StyNW7/Terrava/iot/ear-tag-specifications/tv-et0-classic/terrava-classic-3d-viewer.html

TerravaSMART EAR TAG · TV-ET0 CLASSIC

# Interactive 3D model

Drag to orbit, scroll to zoom. Same geometry as the STEP/STL files.

Explode 0%

Show

Front shell Electronics

Colourway

Signature Mint Stealth

Envelope

42 × 66 × 18 mm

Weight

≈ 44 g with electronics

Radio

LoRaWAN AS923-2 (SX1262)

Sensors

IR temp · PPG · 6-axis IMU · GNSS

Power

LiPo 302535 ~250 mAh + 154 mW solar

Terrava · parametric CAD in cad/terrava_classic.py
