StyNW7/Terrava/iot/ear-tag-specifications/tv-et1-shield/terrava-ear-tag-3d-viewer.html

TerravaSMART EAR TAG · TV-ET1

# Interactive 3D model

Drag to orbit, scroll to zoom. Same geometry as the STEP/STL files.

Explode 0%

Show

Front shell Electronics

Colourway

Signature Field Stealth

Envelope

46 × 68 × 14 mm

Weight

≈ 48 g with electronics

Radio

LoRaWAN AS923-2 (SX1262)

Sensors

IR temp · PPG · 6-axis IMU · GNSS

Battery

LiPo 602535, ~500 mAh

Terrava · parametric CAD in cad/terrava_ear_tag.py
