StyNW7/Terrava/README-ind.md

<div align="center">

Logo Terrava

# Terrava

### AI-Powered Smart Livestock Ecosystem

**Rawat Lebih Awal. Kelola Lebih Cerdas. Tumbuh Lebih Berkelanjutan.**

Terrava menghubungkan smart ear tag, IoT, cloud, dan kecerdasan buatan agar peternak dapat memantau kesehatan ternak, mendeteksi risiko lebih awal, dan mengambil keputusan berbasis data.

<p>
  🇬🇧 <a href="README.md">English</a> &nbsp;|&nbsp; 🇮🇩 <b>Bahasa Indonesia</b>
</p>

<p>
  
  
  
  
</p>

<p>
  
  
  
  
  
  
  
  
  
  
  
  
</p>

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

<p>
  
  
  
</p>

<p>
  <a href="#-memulai"><b>Memulai</b></a> ·
  <a href="#-fitur-utama"><b>Fitur</b></a> ·
  <a href="#-screenshot"><b>Screenshot</b></a> ·
  <a href="#-tech-stack"><b>Tech Stack</b></a> ·
  <a href="#-akun-demo"><b>Akun Demo</b></a>
</p>

<br />

<picture>
  <source media="(prefers-color-scheme: dark)" srcset="images/screenshots/dark/dashboard.png" />
  Dashboard peternak Terrava
</picture>

<sub>Gambar di atas mengikuti tema GitHub Anda. Versi terang dan gelap dari setiap halaman ada di bagian <a href="#-screenshot">Screenshot</a>.</sub>

</div>

---

## 📑 Daftar Isi

- [Tentang Terrava](#-tentang-terrava)
- [Masalah yang Kami Selesaikan](#-masalah-yang-kami-selesaikan)
- [Cara Kerja](#-cara-kerja)
- [Fitur Utama](#-fitur-utama)
- [Smart Ear Tag](#-smart-ear-tag)
- [Arsitektur Monorepo](#-arsitektur-monorepo)
- [Screenshot](#-screenshot)
- [Tech Stack](#-tech-stack)
- [Struktur Proyek](#-struktur-proyek)
- [Memulai](#-memulai)
- [Akun Demo](#-akun-demo)
- [Environment Variables](#-environment-variables)
- [Data Demo dan Penyimpanan](#-data-demo-dan-penyimpanan)
- [Script yang Tersedia](#-script-yang-tersedia)
- [Deployment](#-deployment)
- [Untuk Siapa Terrava](#-untuk-siapa-terrava)
- [Tujuan Pembangunan Berkelanjutan](#-tujuan-pembangunan-berkelanjutan)
- [Roadmap](#-roadmap)
<!-- - [Tim](#-tim) -->
- [Ucapan Terima Kasih](#-ucapan-terima-kasih)
- [Lisensi](#-lisensi)

---

## 🌱 Tentang Terrava

**Terrava** adalah ekosistem peternakan cerdas yang membantu peternak menjaga kesehatan setiap ekor ternak selama 24 jam sehari, tanpa harus memeriksanya satu per satu secara manual.

**Smart ear tag** yang ringan merekam suhu tubuh, detak jantung, aktivitas, dan lokasi setiap ternak. Data dikirim melalui konektivitas jarak jauh **LoRa** ke gateway, lalu ke **cloud**, tempat **AI** mempelajari pola normal setiap ternak dan menandai hal yang tidak biasa. Peternak melihat semuanya dalam satu **dashboard web**: kesehatan ternak, tanda vital secara langsung, alert beserta rekomendasi tindakan awal, peta peternakan, perangkat, tim, dan laporan yang bisa diunduh.

> [!NOTE]
> Repository ini adalah **monorepo dengan empat layer independen**: `frontend/` (website publik dan dashboard peternak lengkap, prototipe yang berfungsi dengan data demo realistis), `backend/` (API NestJS + Prisma + PostgreSQL), `ai/` (model machine learning Python dan asisten Terra) dan `iot/` (firmware ear tag dan gateway, protokol payload, bridge LoRaWAN, dan simulator armada). Setiap layer bisa diinstal, dijalankan, dan diuji sendiri; integrasi antar-layer adalah langkah berikutnya. Lihat [Arsitektur Monorepo](#-arsitektur-monorepo).

<table>
  <tr>
    <td align="center" width="25%">🩺<br /><b>Deteksi lebih awal</b><br /><sub>Kenali risiko kesehatan sebelum gejalanya terlihat</sub></td>
    <td align="center" width="25%">⏱️<br /><b>Hemat waktu</b><br /><sub>Ganti pemeriksaan manual satu per satu dengan pemantauan berkelanjutan</sub></td>
    <td align="center" width="25%">📊<br /><b>Keputusan berbasis data</b><br /><sub>Catatan kesehatan, tren, dan laporan yang konsisten</sub></td>
    <td align="center" width="25%">🌍<br /><b>Peternakan berkelanjutan</b><br /><sub>Ternak lebih sehat, kerugian lebih kecil, sumber daya lebih efisien</sub></td>
  </tr>
</table>

---

## 🎯 Masalah yang Kami Selesaikan

| Tantangan di peternakan | Jawaban Terrava |
| --- | --- |
| **Gejala penyakit terdeteksi terlambat.** Perubahan kondisi baru disadari ketika gejalanya sudah terlihat jelas. | Pemantauan tanda vital berkelanjutan dan deteksi anomali AI memunculkan risiko sejak tahap paling awal. |
| **Pemantauan manual menguras waktu dan tenaga.** Memeriksa ternak satu per satu memakan waktu berjam-jam. | Ear tag melapor secara otomatis; dashboard menunjukkan ternak mana yang perlu perhatian saat ini juga. |
| **Data kesehatan tercatat tidak konsisten.** Catatan tersebar dan jarang terdokumentasi dengan rapi. | Setiap ternak memiliki profil digital berisi riwayat kesehatan, catatan tindakan, dan status perangkat. |
| **Respons yang lambat memperbesar kerugian.** Penanganan yang tertunda menurunkan produktivitas dan pendapatan. | Smart alert datang lengkap dengan tingkat keparahan, penanggung jawab, dan rekomendasi tindakan awal. |

---

## ⚙️ Cara Kerja

Enam langkah otomatis mengubah sinyal dari setiap ternak menjadi keputusan yang bisa langsung dijalankan.

```mermaid
flowchart LR
    A["🏷️ Smart Ear Tag<br/>suhu · detak jantung<br/>aktivitas · GPS"] --> B["📡 LoRa Gateway<br/>jarak jauh, hemat daya"]
    B --> C["☁️ Cloud<br/>penyimpanan & sinkronisasi aman"]
    C --> D["🧠 Analisis AI<br/>baseline per ternak<br/>deteksi anomali"]
    D --> E["📊 Dashboard & Alert<br/>status ternak · peringatan dini"]
    E --> F["👩‍🌾 Tindakan Peternak<br/>respons cepat dengan<br/>rekomendasi yang jelas"]
```

| Langkah | Yang terjadi |
| :---: | --- |
| 1️⃣ **Smart Ear Tag** | Merekam suhu, detak jantung, aktivitas, dan lokasi setiap ternak. |
| 2️⃣ **LoRa Gateway** | Mengirim data jarak jauh dengan konsumsi daya yang sangat rendah. |
| 3️⃣ **Cloud** | Menyimpan dan menyinkronkan data secara aman. |
| 4️⃣ **Analisis AI** | Mempelajari pola normal setiap ternak dan menandai anomali sebelum gejala terlihat. |
| 5️⃣ **Dashboard & Alert** | Menyajikan status ternak, tren, dan peringatan dini dalam satu tampilan. |
| 6️⃣ **Tindakan Peternak** | Peternak merespons cepat dengan panduan rekomendasi yang jelas. |

---

## 🧱 Arsitektur Monorepo

```mermaid
flowchart LR
  subgraph IOT["iot/  (C++ · Python)"]
    TAG["Firmware smart ear tag\nESP32 + LoRa + sensor"]
    GW["Firmware gateway LoRa"]
    SIM["Simulator armada · bridge LoRaWAN"]
  end
  subgraph BE["backend/  (NestJS · Prisma · PostgreSQL)"]
    ING["Ingest IoT + rule engine"]
    API["REST API + Socket.IO"]
    JOBS["Job: deteksi offline, insight,\nlaporan terjadwal, cuaca"]
  end
  subgraph AI["ai/  (FastAPI · scikit-learn · Claude)"]
    ML["Model kesehatan · deteksi anomali\nforecasting · estrus · heat stress"]
    BOT["Asisten Terra"]
  end
  FE["frontend/  (React · Vite PWA)"]
  TAG -- LoRaWAN / P2P --> GW --> ING
  SIM -. HTTP .-> ING
  ING --> API
  API -. "berikutnya: integrasi" .- FE
  API -. "berikutnya: integrasi" .- ML
  FE -. "berikutnya: widget chat" .- BOT
```

| Layer | Stack | Isi | Cara menjalankan |
| --- | --- | --- | --- |
| [`frontend/`](frontend) | React 18, TypeScript, Vite, Tailwind, PWA | Website publik + prototipe dashboard peternak lengkap (data demo di browser) | `npm install && npm run dev` |
| [`backend/`](backend) | NestJS 12, Prisma 7, PostgreSQL (Neon / Supabase / embedded), Socket.IO | API multi-tenant untuk semua modul dashboard, RBAC, ingest IoT dengan rule engine (alert yang de-duplikasi, eskalasi, dan auto-resolve), AI insight, laporan PDF/CSV dengan jadwal email, notifikasi (in-app, email, WhatsApp), event realtime | `npm run db:local` · `npm run db:deploy && npm run db:seed` · `npm run dev` |
| [`ai/`](ai) | Python 3.12, FastAPI, scikit-learn, Claude API | Klasifikasi kondisi (demam, heat stress, pernapasan, pincang, estrus, metabolik), skor kesehatan dengan penjelasan, deteksi anomali, forecasting Holt-Winters, analitik estrus dan heat stress, insight kawanan, chatbot Terra (streaming, tool use, mode offline) | `pip install -r requirements-dev.txt` · `python -m terrava_ai serve` |
| [`iot/`](iot) | C++ (PlatformIO, ESP32, RadioLib), Python | Protokol payload LoRa biner, firmware ear tag (sensor, LoRaWAN OTAA, deep sleep, buffer flash, downlink), gateway satu kanal, bridge TTN/ChirpStack, simulator armada berbasis skenario | `python -m terrava_iot simulate --api http://localhost:4000/api/v1` |

**Kontrak bersama, siap diintegrasikan**

- Backend memakai tipe yang sama dengan frontend (`frontend/src/types/dashboard.ts`): nama field, nilai kebab-case, dan teks dua bahasa `{ id, en }` yang sama; seed-nya mereproduksi dataset prototipe dengan id yang sama (`farm-1`, `LVS-001`, `DEV-001`, `ALT-001`...).
- Layer IoT mengirim persis format yang diterima `/api/v1/ingest/*`; formatter TTN, codec C, dan codec Python berbagi satu set test vector.
- Layer AI mengembalikan insight dalam bentuk `AIInsight` milik dashboard dan hasil kesehatan dengan pita status yang sama seperti backend.

**Sudah diverifikasi di repository ini**: backend — build TypeScript, 45 unit test, dan smoke test end-to-end 25 skenario terhadap database yang sudah di-seed; AI — 35 test (model, time series, API, tool loop asisten); IoT — 31 test termasuk kecocokan byte-per-byte antara codec Python dan formatter JavaScript TTN, uji loop tertutup simulator terhadap backend (telemetri → alert → perintah downlink → acknowledgement), serta build PlatformIO firmware ear tag (LoRaWAN dan P2P) dan gateway.

---

## ✨ Fitur Utama

### 🌐 Website Publik

| Halaman | Isi |
| --- | --- |
| **Home** | Hero, mitra, masalah yang dihadapi peternak, alur enam langkah, fitur inti, pratinjau dashboard, sorotan ear tag, target pengguna, kapabilitas prototipe, cerita pilot, dan FAQ |
| **About** | Visi dan misi, nilai-nilai, rekognisi, <!-- tim, -->dan kontribusi SDG |
| **Solutions** | Delapan solusi, masing-masing dengan masalah, jawaban Terrava, kapabilitas, dan manfaatnya |
| **Smart Ear Tag** | Gambaran produk, sensor, anatomi perangkat, konektivitas, energi, kenyamanan dan keamanan, alur data, serta spesifikasi |
| **How It Works** | Perjalanan data, alur kerja teknis, perjalanan peternak, peran pengguna, dan akses platform |
| **Impact** | Pilar dampak (kesehatan hewan, produktivitas, ketahanan pangan, peternakan berkelanjutan), grafik, SDGs, dan visi jangka panjang |
| **Contact** | Pilihan kontak, formulir kontak, dan FAQ |
| **Auth** | Login (dengan akun demo sekali klik), registrasi multi-langkah, lupa/reset password, dan onboarding |

### 🖥️ Dashboard Peternak

| Modul | Sorotan |
| --- | --- |
| 🏠 **Dashboard Overview** | Sapaan personal, KPI ternak, tren kesehatan, distribusi kesehatan, frekuensi alert, aktivitas, uptime perangkat, serta panel alert, ternak yang perlu perhatian, masalah perangkat, rekomendasi AI, dan tugas. **Export Ringkasan** mengunduh ringkasan dalam bentuk PDF. |
| 🐄 **Ternak** | Tabel yang bisa dicari dan difilter, dengan aksi massal dan ekspor CSV. Halaman detail dengan tab Overview, Tanda Vital, Riwayat Kesehatan, Alert, Lokasi, Perangkat, dan Timeline Aktivitas. Tambah atau ubah ternak (cek ID unik, unggah foto, pasang ear tag, simpan draf), pindah kandang, serta arsipkan atau pulihkan. |
| 💓 **Live Monitoring** | Tanda vital yang diperbarui setiap beberapa detik, penanda ternak yang melewati ambang alert Anda, tampilan kartu atau tabel, jeda/lanjutkan, dan **Mode Control Room** layar penuh. |
| 🚨 **Pusat Alert** | Filter berdasarkan tingkat keparahan, kategori, dan status. Tandai diketahui, selesaikan, buka kembali, atau tugaskan alert satu per satu maupun sekaligus. Setiap alert punya catatan, timeline, alert terkait, dan tombol **Buat Tugas**. |
| 🧠 **AI Insights** | Insight per kategori dan prioritas, tren risiko, serta penyelesaian tindakan. Tandai sudah ditinjau, sembunyikan (bisa diurungkan), atau jadikan insight sebagai tugas. |
| 🗺️ **Peta Peternakan** | Pin ternak berwarna sesuai kondisi kesehatan, kandang, gateway, geofence, layer peta/satelit, filter status, "tampilkan semua", dan daftar ternak yang tersinkron untuk terbang ke setiap ternak. |
| 🏡 **Peternakan dan Kandang** | Tambah dan ubah peternakan, tambah kandang, dan lihat statistik okupansi, kesehatan, dan perangkat per peternakan. |
| 📡 **Perangkat** | Ear tag dan gateway lengkap dengan baterai, sinyal, dan firmware. Restart, jalankan diagnostik, mulai atau akhiri perawatan, pasangkan ke ternak, dan tinjau log kejadian. |
| 👥 **Tim dan Staf** | Undang anggota, ubah peran dan penugasan peternakan, nonaktifkan atau hapus anggota (dengan perlindungan untuk diri sendiri dan Owner terakhir). |
| 📈 **Laporan dan Analitik** | Sepuluh grafik yang mengikuti filter secara langsung. Pustaka enam laporan (kesehatan, alert, perangkat, operasional peternakan, lingkungan/THI, staf) yang bisa **dipratinjau**, diunduh sebagai **PDF** atau **CSV** sungguhan, dan **dijadwalkan**. Setiap unduhan tersimpan di riwayat laporan. |
| ⚙️ **Pengaturan** | Profil (dengan foto), Pengaturan Peternakan, Notifikasi, Ambang Alert, Tampilan (tema, mode ringkas, sidebar), Keamanan (ganti password), serta Data dan Privasi (ekspor JSON, reset data demo, hapus akun). |

### 🧩 Di Seluruh Aplikasi

- 🌗 **Mode terang dan gelap**: mengikuti sistem atau pilihan Anda, diterapkan sebelum halaman tampil sehingga tidak berkedip.
- 🌏 **Dua bahasa**: terjemahan lengkap bahasa Indonesia dan Inggris, bisa diganti dari halaman mana pun.
- 📱 **Responsif**: dirancang untuk ponsel, tablet, hingga layar besar ruang kontrol.
- 📲 **PWA yang bisa dipasang**: tetap berjalan offline, menyimpan cache aplikasi dan tile peta, serta memberi tahu saat ada versi baru.
- 🔎 **Pencarian global** dengan <kbd>Ctrl</kbd> + <kbd>K</kbd>, panel bantuan dengan <kbd>?</kbd>, pusat notifikasi, dan breadcrumb.
- 🧭 **Filter di header**: pilihan peternakan dan rentang tanggal mengubah data di dashboard overview.
- 🔐 **Rute terlindungi**: halaman dashboard memerlukan login; sesi bisa diingat.
- ♿ **Aksesibel**: markup semantik, status fokus keyboard, dan dukungan reduced motion.
- 🖨️ **Ramah cetak**: halaman dashboard dicetak tanpa elemen navigasi.

---

## 🏷️ Smart Ear Tag

Smart ear tag Terrava dirancang hemat daya. Perangkat ini mengumpulkan data fisiologis, aktivitas, dan lokasi tanpa mengganggu ternak.

<div align="center">
  Smart ear tag Terrava pada sapi
  Anatomi smart ear tag Terrava
</div>

<br />

| Komponen | Spesifikasi |
| --- | --- |
| 🧠 MCU | Mikrokontroler 32-bit hemat daya |
| 🌡️ Sensor suhu | Sensor suhu tubuh digital |
| ❤️ Sensor detak jantung | Sensor optik detak jantung dan kadar oksigen |
| 🏃 Sensor gerak | Akselerometer dan giroskop 6 sumbu |
| 📍 GPS | Modul GPS hemat daya |
| 📡 Konektivitas | Nirkabel jarak jauh LoRa |
| 💾 Memori | Penyimpanan flash eksternal (menampung data sebelum dikirim) |
| 🔋 Baterai | Baterai isi ulang hemat daya, 60–80 hari tanpa solar (target) |
| ☀️ Panel surya | Dukungan pengisian daya tenaga surya (opsional) |
| ⏲️ Interval data | Pengiriman berkala yang bisa diatur |

---

## 📸 Screenshot

Setiap halaman ditampilkan dalam kedua tema. Screenshot diambil pada resolusi 1440 × 900 dengan antarmuka berbahasa Inggris; seluruh antarmuka juga tersedia dalam bahasa Indonesia.

<table>
  <tr>
    <th width="50%">☀️ Mode Terang</th>
    <th width="50%">🌙 Mode Gelap</th>
  </tr>
  <tr><td colspan="2" align="center"><b>Landing Page</b></td></tr>
  <tr>
    <td>Landing page, mode terang</td>
    <td>Landing page, mode gelap</td>
  </tr>
  <tr><td colspan="2" align="center"><b>Login dengan Akun Demo</b></td></tr>
  <tr>
    <td>Halaman login, mode terang</td>
    <td>Halaman login, mode gelap</td>
  </tr>
  <tr><td colspan="2" align="center"><b>Dashboard Overview</b></td></tr>
  <tr>
    <td>Dashboard overview, mode terang</td>
    <td>Dashboard overview, mode gelap</td>
  </tr>
  <tr><td colspan="2" align="center"><b>Daftar Ternak</b></td></tr>
  <tr>
    <td>Daftar ternak, mode terang</td>
    <td>Daftar ternak, mode gelap</td>
  </tr>
  <tr><td colspan="2" align="center"><b>Detail Ternak</b></td></tr>
  <tr>
    <td>Detail ternak, mode terang</td>
    <td>Detail ternak, mode gelap</td>
  </tr>
  <tr><td colspan="2" align="center"><b>Live Monitoring</b></td></tr>
  <tr>
    <td>Live monitoring, mode terang</td>
    <td>Live monitoring, mode gelap</td>
  </tr>
  <tr><td colspan="2" align="center"><b>Pusat Alert</b></td></tr>
  <tr>
    <td>Pusat alert, mode terang</td>
    <td>Pusat alert, mode gelap</td>
  </tr>
  <tr><td colspan="2" align="center"><b>AI Insights</b></td></tr>
  <tr>
    <td>AI insights, mode terang</td>
    <td>AI insights, mode gelap</td>
  </tr>
  <tr><td colspan="2" align="center"><b>Peta dan Pelacakan Peternakan</b></td></tr>
  <tr>
    <td>Peta peternakan, mode terang</td>
    <td>Peta peternakan, mode gelap</td>
  </tr>
  <tr><td colspan="2" align="center"><b>Laporan dan Analitik</b></td></tr>
  <tr>
    <td>Laporan dan analitik, mode terang</td>
    <td>Laporan dan analitik, mode gelap</td>
  </tr>
  <tr><td colspan="2" align="center"><b>Pustaka Laporan (PDF, CSV, dan Penjadwalan)</b></td></tr>
  <tr>
    <td>Pustaka laporan, mode terang</td>
    <td>Pustaka laporan, mode gelap</td>
  </tr>
  <tr><td colspan="2" align="center"><b>Pratinjau Laporan</b></td></tr>
  <tr>
    <td>Pratinjau laporan, mode terang</td>
    <td>Pratinjau laporan, mode gelap</td>
  </tr>
  <tr><td colspan="2" align="center"><b>Manajemen Perangkat</b></td></tr>
  <tr>
    <td>Manajemen perangkat, mode terang</td>
    <td>Manajemen perangkat, mode gelap</td>
  </tr>
  <tr><td colspan="2" align="center"><b>Halaman Smart Ear Tag</b></td></tr>
  <tr>
    <td>Halaman smart ear tag, mode terang</td>
    <td>Halaman smart ear tag, mode gelap</td>
  </tr>
</table>

<details>
<summary><b>📱 Tampilan mobile</b> (klik untuk membuka)</summary>
<br />

<table>
  <tr>
    <th>☀️ Landing</th>
    <th>☀️ Dashboard</th>
    <th>🌙 Landing</th>
    <th>🌙 Dashboard</th>
  </tr>
  <tr>
    <td>Landing mobile, mode terang</td>
    <td>Dashboard mobile, mode terang</td>
    <td>Landing mobile, mode gelap</td>
    <td>Dashboard mobile, mode gelap</td>
  </tr>
</table>

</details>

---

## 🛠️ Tech Stack

| Lapisan | Teknologi |
| --- | --- |
| **Framework** | [React 18](https://react.dev/) + [TypeScript 5.8](https://www.typescriptlang.org/) |
| **Build tool** | [Vite 6](https://vite.dev/) |
| **Styling** | [Tailwind CSS 3.4](https://tailwindcss.com/), `tailwindcss-animate`, `class-variance-authority`, `tailwind-merge` |
| **Animasi** | [Framer Motion 12](https://motion.dev/) (menghormati pengaturan reduced motion) |
| **Routing** | [React Router 7](https://reactrouter.com/) dengan rute dashboard yang terlindungi |
| **Form dan validasi** | [React Hook Form 7](https://react-hook-form.com/) + [Zod 4](https://zod.dev/) |
| **Tabel** | [TanStack Table 8](https://tanstack.com/table) |
| **Grafik** | [Recharts 3](https://recharts.org/) |
| **Peta** | [Leaflet 1.9](https://leafletjs.com/) + [React Leaflet 4](https://react-leaflet.js.org/) dengan tile CARTO, OpenStreetMap, dan Esri World Imagery |
| **Laporan** | [jsPDF 4](https://github.com/parallax/jsPDF) + [jspdf-autotable 5](https://github.com/simonbengtsson/jsPDF-AutoTable) (dimuat saat dibutuhkan), ekspor CSV |
| **Ikon dan UI** | [Lucide](https://lucide.dev/), komponen dasar Radix UI, pola shadcn/ui |
| **Notifikasi** | [react-hot-toast](https://react-hot-toast.com/) |
| **Tanggal** | [date-fns 4](https://date-fns.org/) |
| **PWA** | [vite-plugin-pwa](https://vite-pwa-org.netlify.app/) + Workbox |
| **Kualitas kode** | ESLint 9, `typescript-eslint`, aturan lint React Hooks |
| **Hosting** | [Vercel](https://vercel.com/) (SPA rewrites di `vercel.json`) |

**Layer backend, AI, dan IoT**

| Lapisan | Teknologi |
| --- | --- |
| **Framework API** | [NestJS 12](https://nestjs.com/) (Express 5), class-validator, Swagger / OpenAPI di `/docs` |
| **Database** | [PostgreSQL](https://www.postgresql.org/) melalui [Prisma 7](https://www.prisma.io/) (driver adapter pg) di [Neon](https://neon.tech/), [Supabase](https://supabase.com/), atau Postgres lokal embedded |
| **Auth & keamanan** | JWT access token + refresh token berotasi dengan deteksi reuse, bcrypt, guard RBAC, Helmet, rate limiting, audit log |
| **Realtime & job** | Gateway Socket.IO, cron job `@nestjs/schedule`, domain event EventEmitter |
| **Laporan & pesan** | PDFKit, CSV, Nodemailer (SMTP), gateway HTTP WhatsApp, cuaca Open-Meteo |
| **Layanan AI** | [FastAPI](https://fastapi.tiangolo.com/), [scikit-learn](https://scikit-learn.org/) (HistGradientBoosting, IsolationForest), NumPy, pandas |
| **Asisten** | [Claude](https://www.anthropic.com/claude) (`claude-opus-5-5`) melalui Anthropic Python SDK: streaming, tool use, prompt caching, server-side fallback; retrieval pengetahuan TF-IDF |
| **Firmware** | C++ / Arduino di ESP32 dengan [PlatformIO](https://platformio.org/), [RadioLib](https://github.com/jgromes/RadioLib) (LoRaWAN 1.1 OTAA, AS923-2), TinyGPS++, MAX3010x, MLX90614, MPU6050, XPowersLib, LittleFS |
| **Tooling IoT** | Python: codec biner, simulator armada, bridge MQTT (paho-mqtt) untuk The Things Stack / ChirpStack dengan outbox SQLite |
| **Pengujian** | Jest, pytest, smoke test end-to-end, test vector protokol bersama, Unity (firmware) |

---

## 🗂️ Struktur Proyek

```text
Terrava/
├── frontend/                    # Platform web Terrava (React + Vite)
│   ├── public/
│   │   ├── icons/               # Ikon PWA dan favicon
│   │   └── Images/              # Foto produk, mockup, avatar
│   ├── src/
│   │   ├── components/
│   │   │   ├── auth/            # Login, registrasi, kartu akun demo
│   │   │   ├── charts/          # Komponen grafik Recharts
│   │   │   ├── dashboard/       # Layout, header, sidebar, tabel, modal, panel
│   │   │   ├── devices/ farms/ livestock/ reports/ settings/ team/
│   │   │   ├── layout/          # Navbar dan footer publik
│   │   │   ├── sections/        # Section landing dan halaman marketing
│   │   │   ├── pwa/             # Prompt pemasangan dan pembaruan
│   │   │   └── ui/              # Komponen UI dasar
│   │   ├── context/             # Auth, Theme, Language, Settings, Data Store, Dashboard
│   │   ├── data/                # Dataset demo dan konten website
│   │   ├── hooks/               # Hook reusable (data store, laporan, perangkat, pengaturan…)
│   │   ├── i18n/                # Kamus bahasa Indonesia dan Inggris
│   │   ├── lib/                 # Laporan, ekspor PDF/CSV, tile peta, penjadwalan
│   │   ├── pages/               # Halaman publik, auth, dan dashboard
│   │   ├── schemas/             # Skema validasi Zod
│   │   ├── types/               # Tipe TypeScript bersama
│   │   └── utils/               # Waktu, gambar, ikon peta, pembacaan live
│   ├── .env.example             # Template API key peta
│   ├── vercel.json              # SPA rewrites untuk Vercel
│   ├── vite.config.ts           # Konfigurasi Vite, path alias, dan PWA
│   └── README.md                # Catatan teknis frontend
├── backend/                     # API NestJS + Prisma (lihat backend/README.md)
│   ├── prisma/                  # skema (28 model), migrasi, seed demo
│   ├── scripts/                 # Postgres embedded, smoke test end-to-end
│   └── src/                     # config, domain logic, common, modules/*
├── ai/                          # Layanan ML FastAPI + asisten Terra (lihat ai/README.md)
│   ├── terrava_ai/              # ml/ (model), chat/ (asisten + pengetahuan), api/
│   └── tests/
├── iot/                         # Firmware, protokol, bridge, simulator (lihat iot/README.md)
│   ├── protocol/                # PAYLOAD.md, codec C, formatter TTN, test vector
│   ├── firmware/ear-tag/        # Ear tag ESP32 (PlatformIO)
│   ├── firmware/gateway/        # Gateway LoRa ESP32 (PlatformIO)
│   └── terrava_iot/             # Codec Python, simulator, bridge MQTT
├── images/                      # Logo dan screenshot README (light/ dan dark/)
├── README.md                    # Dokumentasi (bahasa Inggris)
└── README-ind.md                # Dokumentasi (bahasa Indonesia)
```

---

## 🚀 Memulai

### Prasyarat

- [Node.js](https://nodejs.org/) **18 atau lebih baru** (disarankan 20 LTS)
- npm (sudah termasuk dalam Node.js)
- Git

### Instalasi

```bash
# 1. Clone repository
git clone https://github.com/StyNW7/Terrava.git

# 2. Masuk ke folder frontend
cd Terrava/frontend

# 3. Install dependency
npm install

# 4. (Opsional) tambahkan API key peta, lihat "Environment Variables"
cp .env.example .env.local

# 5. Jalankan development server
npm run dev
```

Buka **http://localhost:5173**, klik **Coba Dashboard Demo** atau **Login**, lalu masuk dengan akun demo.

> [!TIP]
> Aplikasi langsung berjalan tanpa konfigurasi apa pun. Tanpa API key peta, Peta Peternakan otomatis memakai tile OpenStreetMap.

### Mencoba PWA secara lokal

Service worker hanya dibuat pada build production:

```bash
npm run build
npm run preview
```

Chrome dan Edge di desktop atau Android menawarkan tombol **Install**. Di iOS, gunakan Safari → Share → **Add to Home Screen**.

### Menjalankan layer backend, AI, dan IoT

Setiap layer berdiri sendiri; jalankan yang Anda perlukan saja. Panduan lengkap ada di README masing-masing folder.

```bash
# Backend API (Node.js 22.12+) — http://localhost:4000/api/v1, dokumentasi di /docs
cd backend && npm install && cp .env.example .env
npm run db:local            # terminal 1: PostgreSQL embedded (atau pakai Neon / Supabase)
npm run db:deploy && npm run db:seed && npm run dev   # terminal 2

# Layanan AI (Python 3.11+) — http://localhost:8000/docs
cd ai && python -m venv .venv && .venv/Scripts/activate   # macOS/Linux: source .venv/bin/activate
pip install -r requirements-dev.txt && pip install -e . --no-deps
python -m terrava_ai serve

# Simulator IoT: ear tag virtual mengirim data ke backend
cd iot && python -m venv .venv && .venv/Scripts/activate
pip install -r requirements-dev.txt && pip install -e . --no-deps
python -m terrava_iot simulate --api http://localhost:4000/api/v1 --backfill 6 --speed 600 --scenario DEV-001=fever
```

---

## 🔑 Akun Demo

Prototipe ini dilengkapi akun dummy. Setiap akun langsung masuk ke dashboard peternak, atau gunakan tombol **Masuk langsung** di halaman login.

| Persona | Email | Password |
| --- | --- | --- |
| 👨‍🌾 Pemilik Peternakan | `demo@terrava.id` | `Terrava123` |
| 🧑‍💼 Manajer Peternakan | `manager@terrava.id` | `Terrava123` |
| 🩺 Dokter Hewan | `vet@terrava.id` | `Terrava123` |

> [!IMPORTANT]
> Kredensial ini hanya untuk demonstrasi. Autentikasi berjalan di browser; belum ada database pengguna sungguhan.

---

## 🔐 Environment Variables

Buat `frontend/.env.local` (diabaikan oleh git) dari `frontend/.env.example`.

| Variabel | Wajib | Fungsi |
| --- | :---: | --- |
| `VITE_CARTO_API_KEY` | Opsional | Basemap CARTO untuk Peta Peternakan mode terang dan gelap tanpa watermark "API KEY REQUIRED". Dapatkan key gratis di [carto.com/basemaps/apikey](https://carto.com/basemaps/apikey). |
| `VITE_ARCGIS_API_KEY` | Opsional | Hanya diperlukan jika layer satelit dipindahkan ke paket ArcGIS Location Platform. |

**Menjaga keamanan API key peta**

1. Di dashboard CARTO, batasi key hanya untuk domain Anda (misalnya `localhost` dan domain Vercel Anda). Key peta selalu terlihat di request browser, jadi pembatasan domain inilah yang melindunginya.
2. Simpan key di `.env.local`, yang tidak pernah di-commit.
3. Di Vercel, tambahkan variabel di **Project → Settings → Environment Variables** lalu lakukan redeploy.

Kredit peta untuk OpenStreetMap, CARTO, dan Esri tetap ditampilkan sebagai label atribusi kecil, sesuai ketentuan lisensinya.

---

## 💾 Data Demo dan Penyimpanan

Terrava berjalan dengan dataset yang realistis sehingga setiap fitur bisa langsung dicoba:

| Dataset | Jumlah |
| --- | --- |
| 🏡 Peternakan | 4 peternakan (Green Valley Farm, Lembang Dairy Farm, Nusantara Livestock Center, Terrava Demo Farm), masing-masing dengan kandang |
| 🐄 Ternak | 40 ekor dengan tanda vital, riwayat kesehatan, vaksinasi, dan lokasi |
| 📡 Perangkat | 20 perangkat (smart ear tag dan gateway) dengan log kejadian dan perawatan |
| 🚨 Alert | 18 alert dari kategori kesehatan, perilaku, lokasi, perangkat, lingkungan, dan cuaca |
| 🧠 AI insights | Insight dengan prioritas, tingkat keyakinan, dan rekomendasi tindakan |
| 👥 Tim | 10 anggota dengan peran dan penugasan peternakan |

Setiap aksi (menyelesaikan alert, menambah ternak, mengundang anggota, membuat tugas, dan lainnya) memperbarui satu data store bersama, sehingga perubahannya terlihat di semua halaman. Data disimpan di `localStorage` browser:

| Key | Isi |
| --- | --- |
| `terrava-demo-data` | Ternak, alert, perangkat, peternakan, tim, tugas, insight, riwayat laporan, dan jadwal |
| `terrava-settings` | Pengaturan pengguna (ambang alert, satuan, notifikasi, tampilan, dan lainnya) |
| `terrava-auth-session` | Sesi login |
| `terrava-theme` / `terrava-language` | Preferensi tema dan bahasa |
| `terrava-password-overrides` | Password yang diganti di Pengaturan, disimpan sebagai hash SHA-256 |

Untuk memulai dari awal, buka **Pengaturan → Data dan Privasi → Reset Data Demo**.

> [!NOTE]
> Karena belum ada backend, laporan terjadwal, notifikasi email/WhatsApp, undangan tim, dan formulir kontak masih disimulasikan di browser. Belum ada pesan yang benar-benar terkirim.

---

## 📜 Script yang Tersedia

Jalankan perintah berikut di dalam folder `frontend/`.

| Perintah | Keterangan |
| --- | --- |
| `npm run dev` | Menjalankan development server Vite dengan hot reload |
| `npm run build` | Pengecekan tipe TypeScript dan build production ke folder `dist/` |
| `npm run preview` | Menyajikan hasil build production secara lokal (termasuk service worker) |
| `npm run lint` | Menjalankan ESLint di seluruh proyek |

---

## ☁️ Deployment

Terrava adalah single-page app statis dan mudah di-deploy ke **Vercel**:

1. Import repository di Vercel.
2. Atur **Root Directory** ke `frontend`.
3. Framework preset: **Vite**. Build command `npm run build`, output directory `dist`.
4. Tambahkan `VITE_CARTO_API_KEY` (opsional) di Environment Variables.
5. Deploy. `frontend/vercel.json` sudah mengarahkan semua rute ke `index.html`, sehingga tautan langsung seperti `/dashboard/alerts` tetap berfungsi.

Hosting statis lain (Netlify, Cloudflare Pages, GitHub Pages dengan fallback SPA) juga bisa digunakan.

---

## 🤝 Untuk Siapa Terrava

| Segmen | Kebutuhan |
| --- | --- |
| 🧑‍🌾 **Peternak kecil** | Cara yang lebih mudah untuk mengawasi ternak mereka |
| 🏘️ **Koperasi peternakan** | Data kesehatan dari banyak peternakan anggota |
| 🏭 **Peternakan komersial** | Alat manajemen untuk populasi ternak yang besar |
| 🏛️ **Pemerintah dan institusi veteriner** | Data agregat untuk surveilans kesehatan hewan |

Peran pengguna di platform Terrava: **Peternak**, **Manajer Peternakan**, **Dokter Hewan**, **Administrator Koperasi**, dan **Pemerintah atau Institusi**.

---

## 🌍 Tujuan Pembangunan Berkelanjutan

Terrava berkontribusi pada tujuh Tujuan Pembangunan Berkelanjutan (SDGs) Perserikatan Bangsa-Bangsa:

| SDG | Kontribusi |
| --- | --- |
| **2** · Tanpa Kelaparan | Ketahanan pangan melalui ternak yang produktif secara konsisten |
| **3** · Kehidupan Sehat dan Sejahtera | Deteksi dini risiko kesehatan untuk kesejahteraan hewan yang lebih baik |
| **8** · Pekerjaan Layak dan Pertumbuhan Ekonomi | Peluang baru di bidang teknologi peternakan dan agritech |
| **9** · Industri, Inovasi, dan Infrastruktur | Adopsi IoT dan AI pada infrastruktur peternakan |
| **12** · Konsumsi dan Produksi yang Bertanggung Jawab | Praktik peternakan yang lebih efisien dan bertanggung jawab |
| **13** · Penanganan Perubahan Iklim | Efisiensi sumber daya dan pemantauan lingkungan |
| **15** · Ekosistem Daratan | Pengelolaan lahan penggembalaan dan pertanian yang lebih berkelanjutan |

---

## 🗺️ Roadmap

- [x] Website publik dengan halaman produk, solusi, dan dampak
- [x] Antarmuka dua bahasa (Indonesia dan Inggris) dengan tema terang dan gelap
- [x] Dashboard peternak dengan ternak, monitoring, alert, AI insights, peta, peternakan, perangkat, tim, dan pengaturan
- [x] Laporan PDF dan CSV yang berfungsi, lengkap dengan pratinjau, riwayat, dan penjadwalan
- [x] PWA yang bisa dipasang dengan dukungan offline
- [x] Backend API dan database untuk data multi-pengguna sungguhan (`backend/`)
- [x] Firmware ear tag dan gateway, bridge LoRaWAN, dan protokol payload (`iot/`)
- [x] Model kesehatan, anomali, forecasting, dan estrus serta asisten Terra (`ai/`, dilatih dengan data sintetis)
- [x] Pengiriman email dan WhatsApp untuk alert dan laporan terjadwal (channel di backend)
- [ ] Menghubungkan frontend ke API backend dan event realtime
- [ ] Memanggil layanan AI dari pipeline backend dan menambahkan widget chat di dashboard
- [ ] Pilot lapangan dengan ear tag fisik; melatih ulang model dengan data ternak berlabel
- [ ] Dashboard agregat untuk koperasi dan pemerintah

---

<!-- Team section hidden from the public README; kept for reference.

## 👩‍💻 Tim

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

---
-->

## 🙏 Ucapan Terima Kasih

- Data peta © kontributor [OpenStreetMap](https://www.openstreetmap.org/copyright), basemap oleh [CARTO](https://carto.com/attributions), citra satelit oleh [Esri](https://www.esri.com/)
- Ikon oleh [Lucide](https://lucide.dev/)
- Badge oleh [Shields.io](https://shields.io/)
- Seluruh komunitas peternak yang tantangan sehari-harinya menginspirasi Terrava

---

## 📄 Lisensi

Repository ini belum menyertakan lisensi open-source, sehingga seluruh hak cipta dimiliki oleh tim Terrava. Silakan hubungi tim sebelum menggunakan kembali kode, desain, atau konten di dalamnya.

<div align="center">

<br />

Terrava

**Terrava** · AI-Powered Smart Livestock Ecosystem

<sub>Dibuat dengan 💚 untuk peternak di Indonesia dan dunia.</sub>

<a href="#terrava">⬆ Kembali ke atas</a>

</div>
