StyNW7/Terrava/images/screenshots/device-management.png

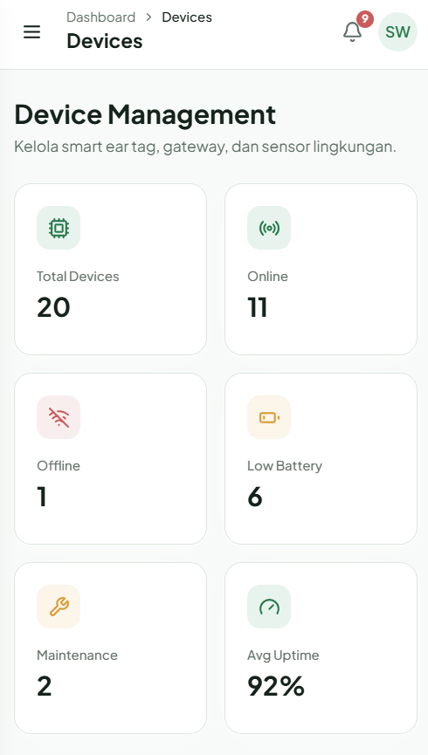
images/screenshots/device-management.png
