StyNW7/Terrava/iot/ear-tag-specifications/images/terrava-ear-tag-lineup.png

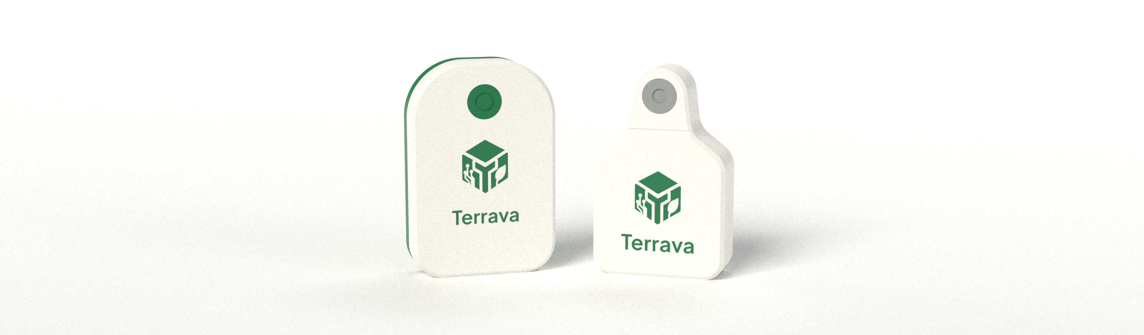
iot/ear-tag-specifications/images/terrava-ear-tag-lineup.png
