StyNW7/Terrava/iot/ear-tag-specifications/references/Prototype-Terrava-Ear-Tag-v1.png

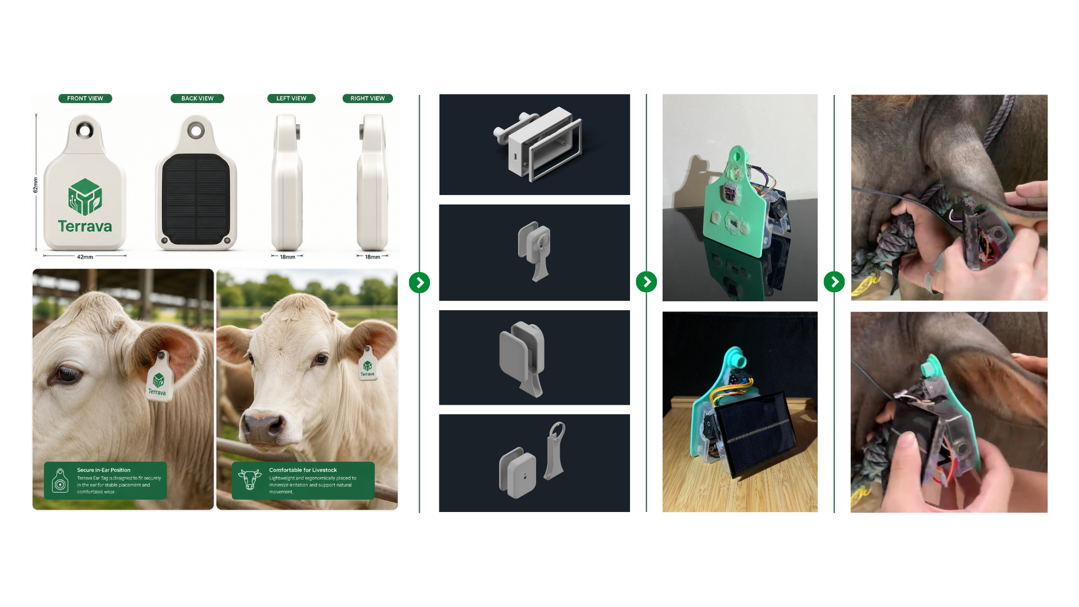
iot/ear-tag-specifications/references/Prototype-Terrava-Ear-Tag-v1.png
