StyNW7/Terrava/iot/ear-tag-specifications/tv-et0-classic/images/drawings/sheet-1-general-arrangement.png

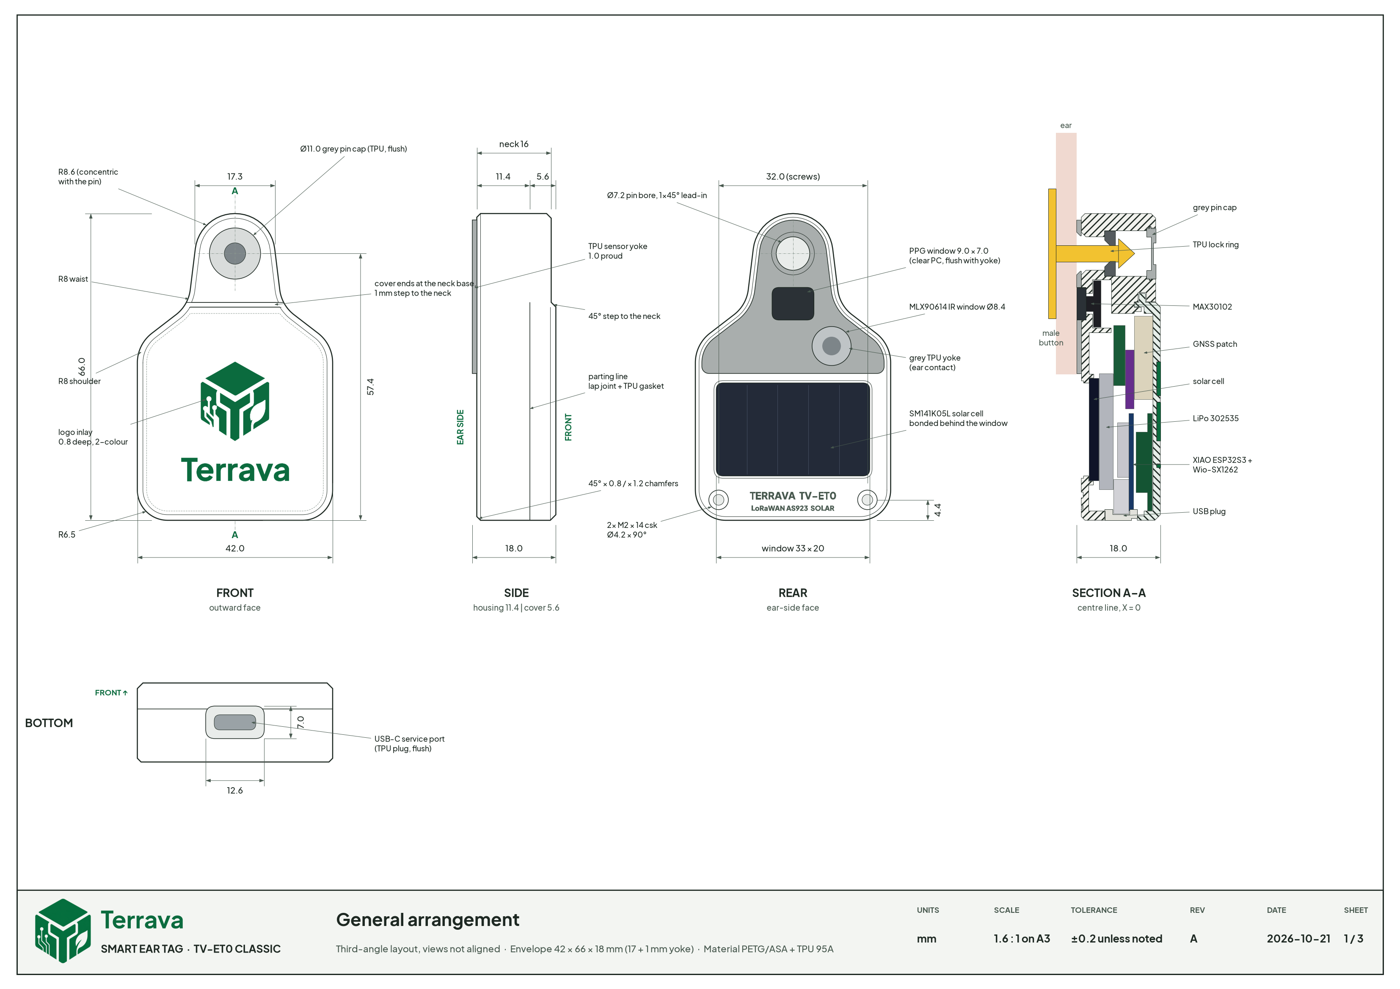
iot/ear-tag-specifications/tv-et0-classic/images/drawings/sheet-1-general-arrangement.png
