StyNW7/Terrava/iot/ear-tag-specifications/tv-et0-classic/images/drawings/sheet-2-internal-layout.png

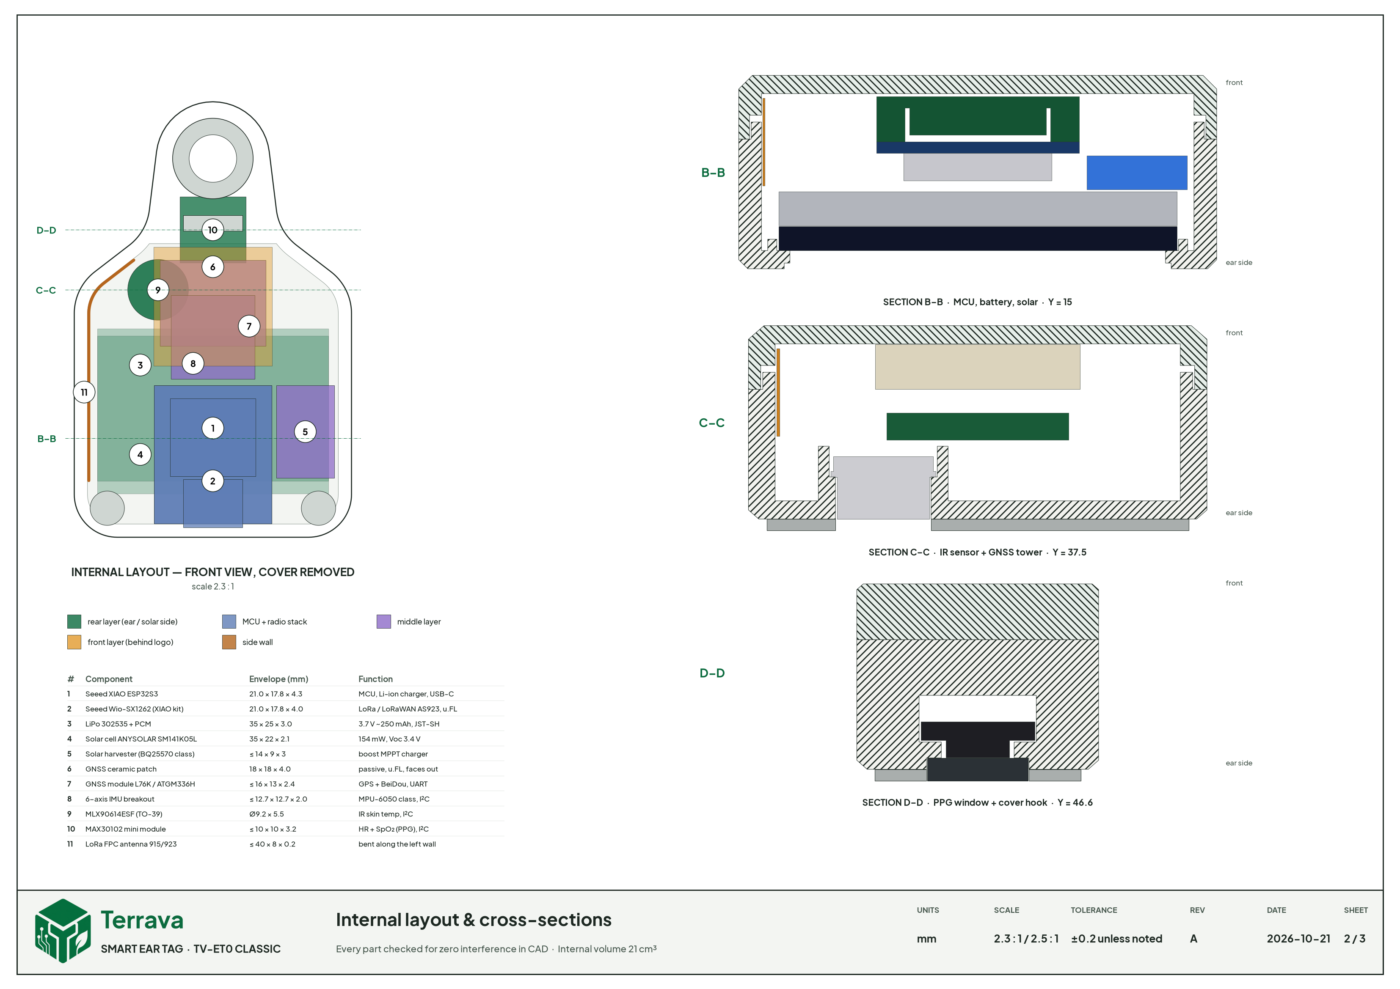
iot/ear-tag-specifications/tv-et0-classic/images/drawings/sheet-2-internal-layout.png
