StyNW7/Terrava/iot/ear-tag-specifications/tv-et0-classic/images/renders/07-mounted-on-ear.png

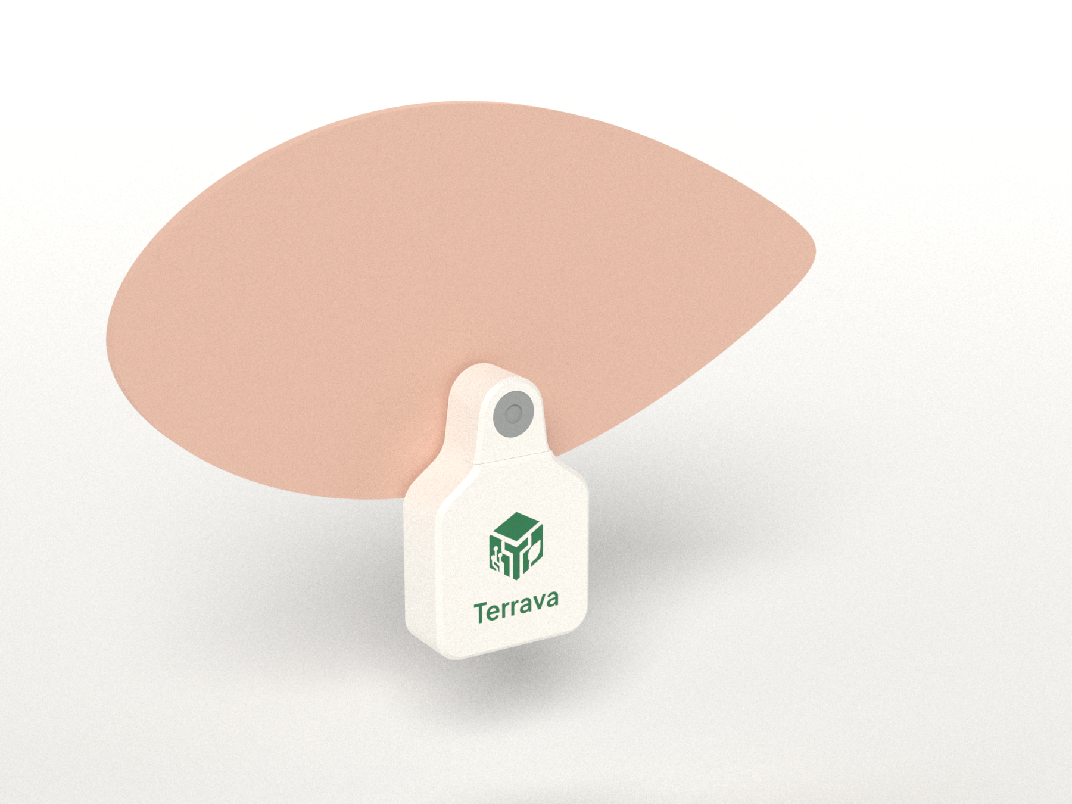
iot/ear-tag-specifications/tv-et0-classic/images/renders/07-mounted-on-ear.png
