StyNW7/Terrava/iot/ear-tag-specifications/tv-et0-classic/images/renders/view-front.png

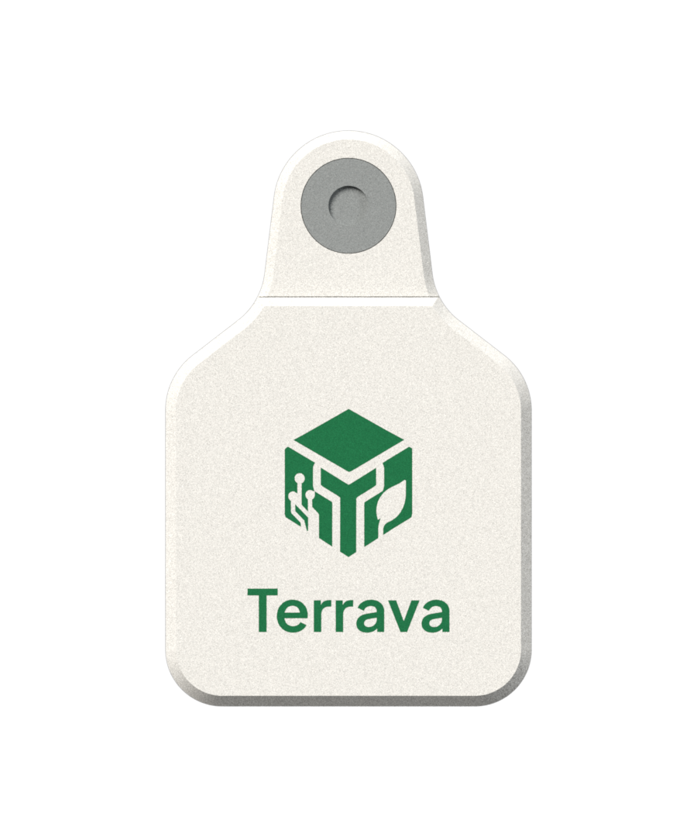
iot/ear-tag-specifications/tv-et0-classic/images/renders/view-front.png
