StyNW7/Terrava/iot/ear-tag-specifications/tv-et0-classic/images/renders/view-left.png

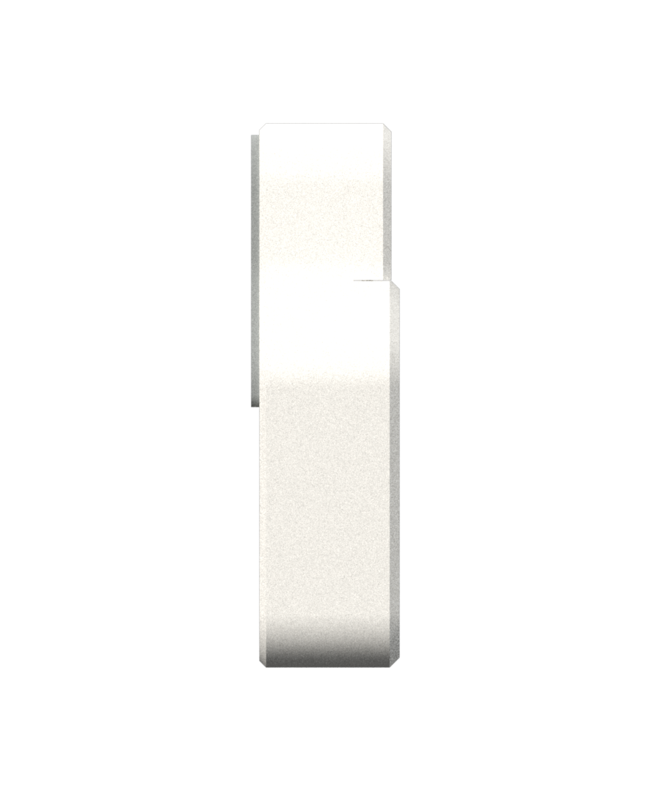
iot/ear-tag-specifications/tv-et0-classic/images/renders/view-left.png
