StyNW7/Terrava/iot/ear-tag-specifications/tv-et1-shield/images/drawings/sheet-1-general-arrangement.png

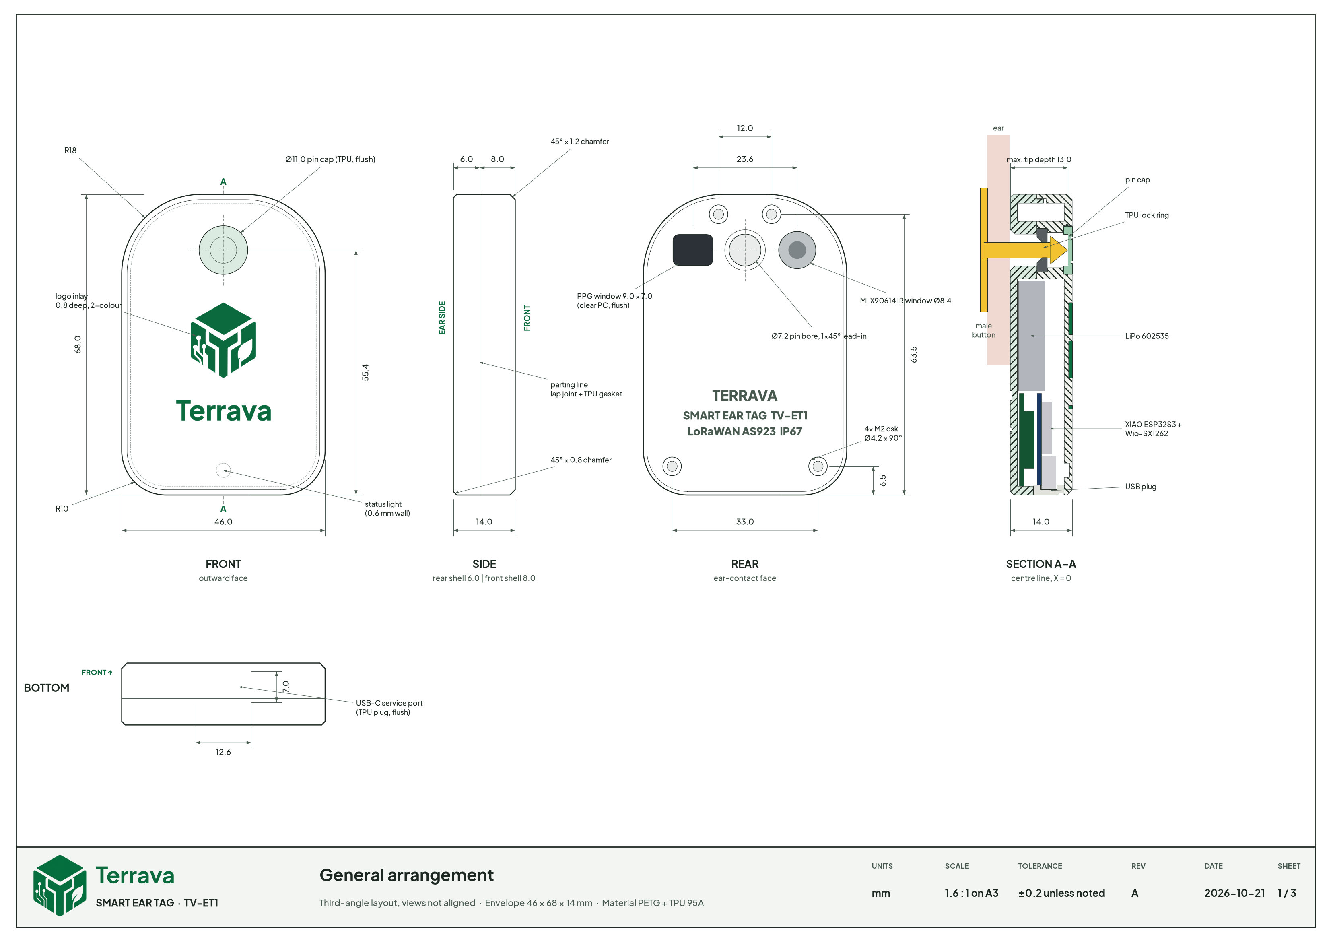
iot/ear-tag-specifications/tv-et1-shield/images/drawings/sheet-1-general-arrangement.png
