StyNW7/Terrava/iot/ear-tag-specifications/tv-et1-shield/images/drawings/sheet-2-internal-layout.png

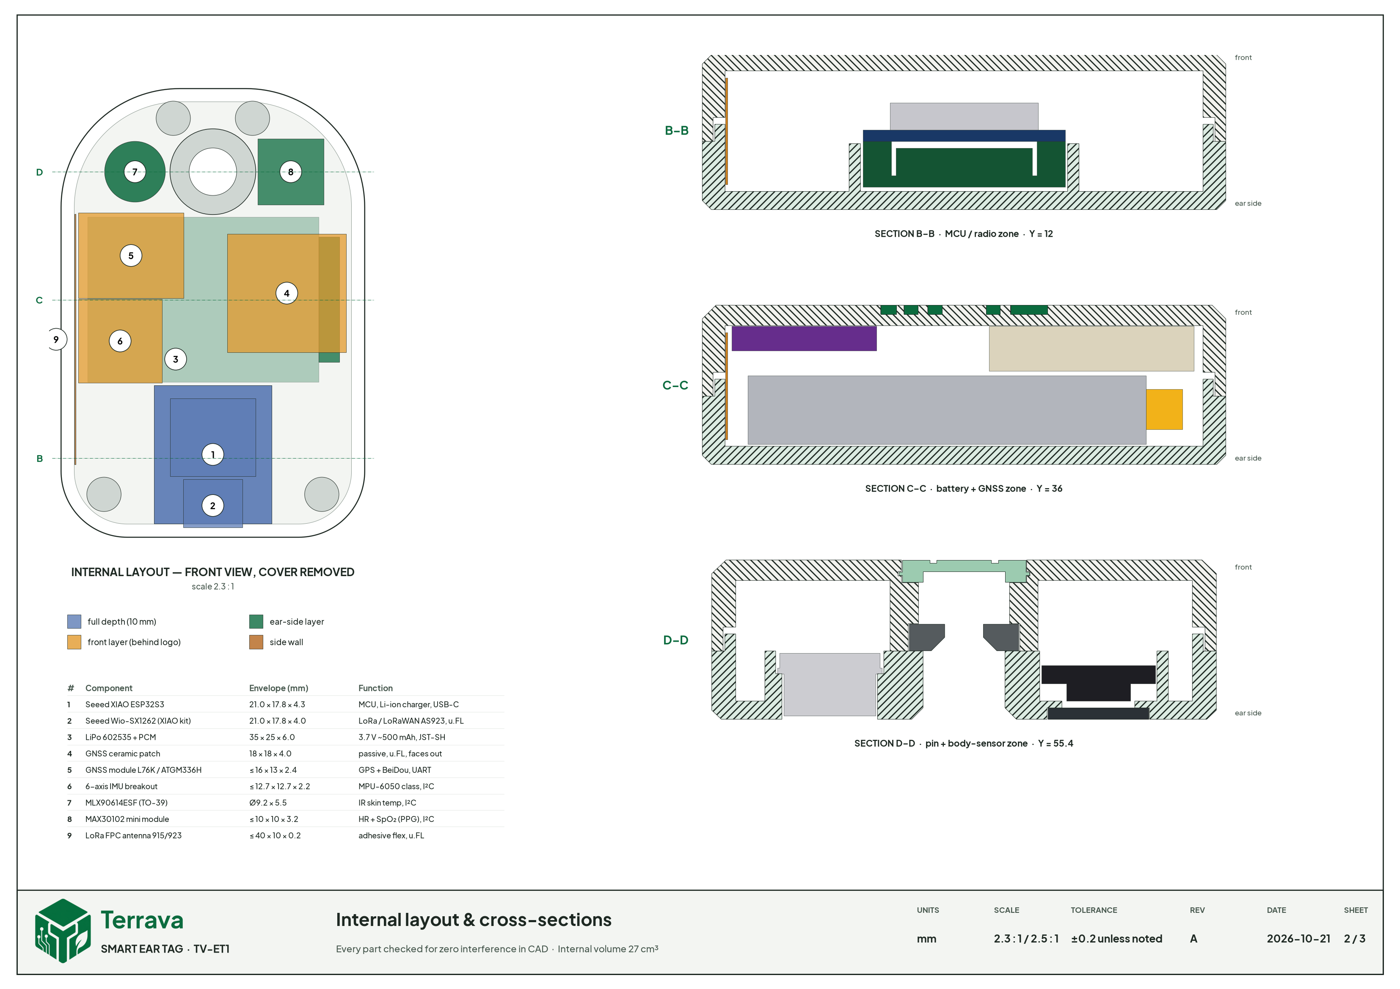
iot/ear-tag-specifications/tv-et1-shield/images/drawings/sheet-2-internal-layout.png
