StyNW7/Terrava/iot/ear-tag-specifications/tv-et1-shield/images/renders/07-mounted-on-ear.png

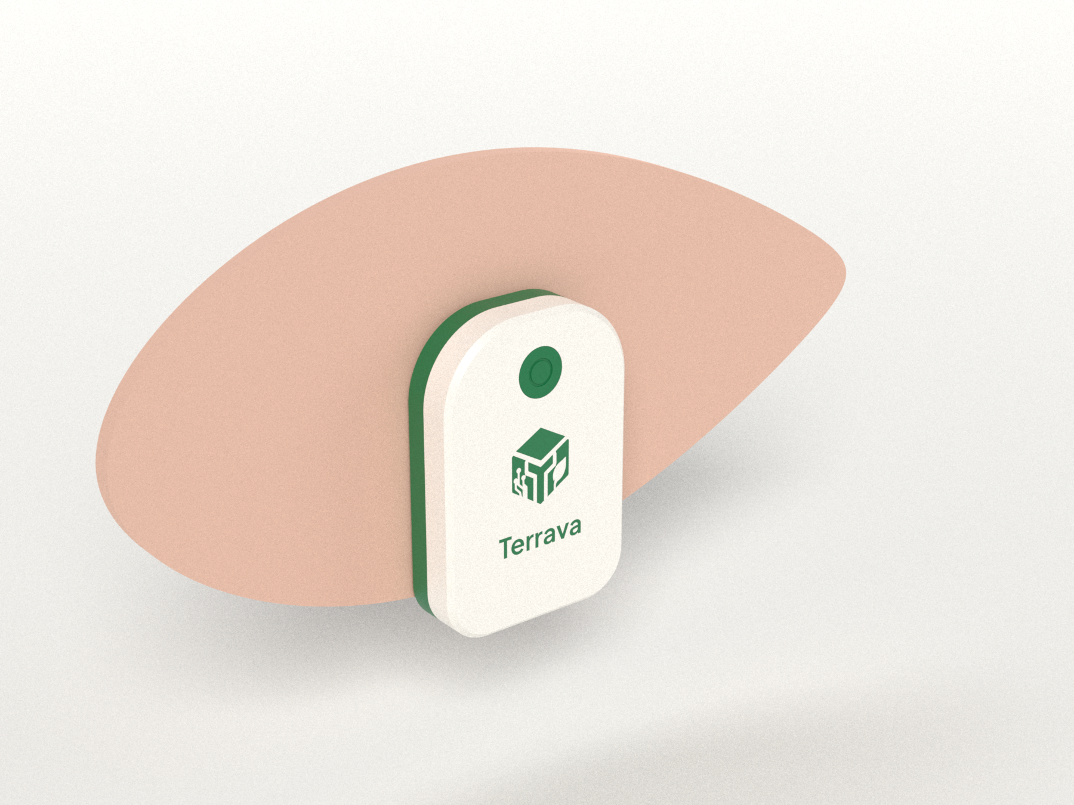
iot/ear-tag-specifications/tv-et1-shield/images/renders/07-mounted-on-ear.png
