StyNW7/Terrava/iot/ear-tag-specifications/tv-et1-shield/images/renders/view-bottom.png

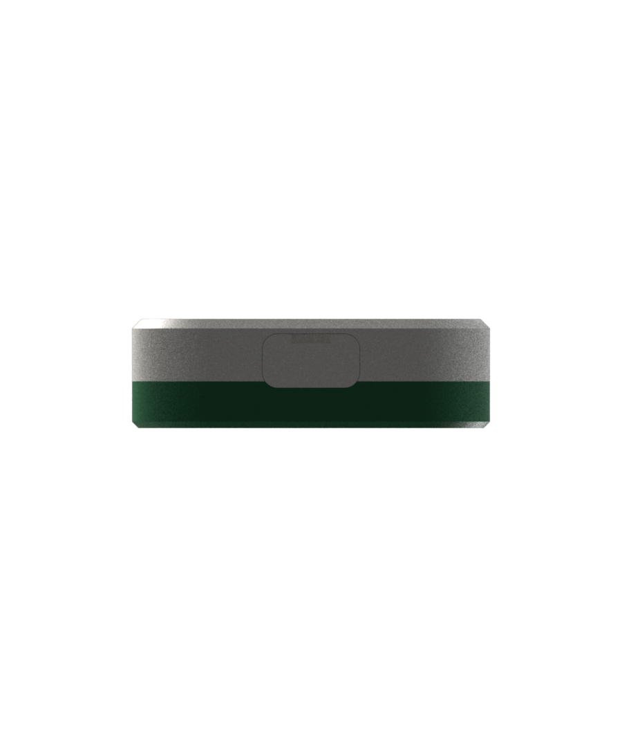
iot/ear-tag-specifications/tv-et1-shield/images/renders/view-bottom.png
