StyNW7/Terrava/iot/ear-tag-specifications/tv-et1-shield/images/renders/view-front.png

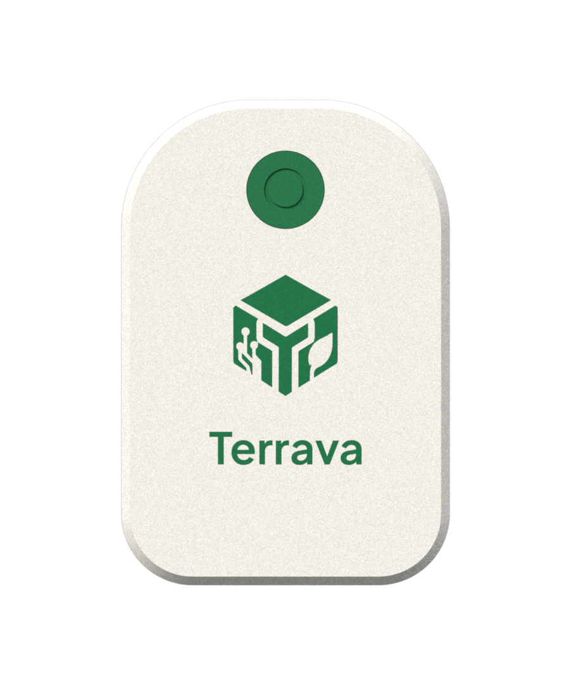
iot/ear-tag-specifications/tv-et1-shield/images/renders/view-front.png
