StyNW7/Terrava/iot/ear-tag-specifications/tv-et1-shield/images/renders/view-left.png

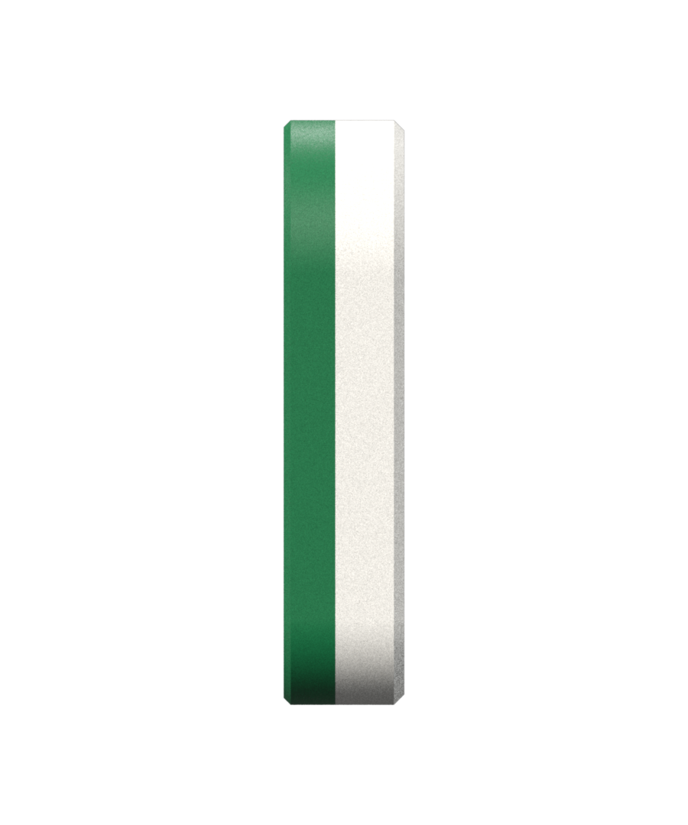
iot/ear-tag-specifications/tv-et1-shield/images/renders/view-left.png
