StyNW7/Terrava/iot/ear-tag-specifications/tv-et0-classic/models/step/terrava-classic-assembly.step

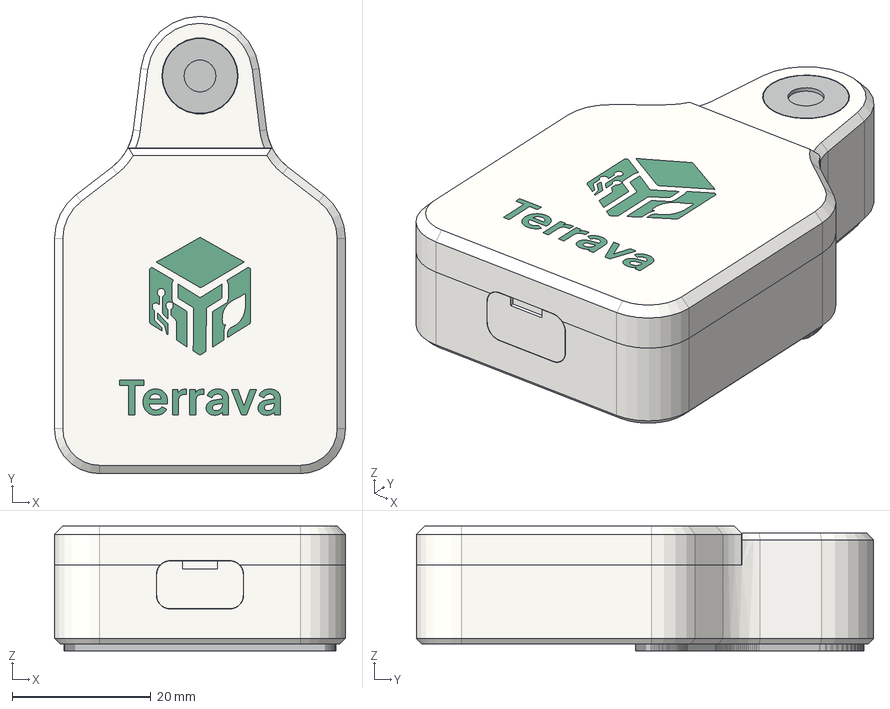
[picture p69: CAD file, 2026-10-21]
iot/ear-tag-specifications/tv-et0-classic/models/step/terrava-classic-assembly.step
42.0 x 66.0 x 18.0 mm
housing
cover
logo_inlay
pin_cap
lock_ring
gasket
usb_plug
ppg_window
yoke
00_Wio-SX1262_LoRa_board
01_XIAO_ESP32S3
02_ESP32-S3_shield
03_USB-C_receptacle
04_Solar_cell_SM141K05L
05_LiPo_302535_250_mAh
06_Solar_harvester
07_GNSS_module_(L76K_/_ATGM336H)
08_6-axis_IMU_breakout
09_GNSS_ceramic_patch_18x18
10_LoRa_FPC_antenna_923_MHz
11_MLX90614_IR_thermometer
12_MAX30102_PPG_sensor
13_M2x14_countersunk_screw
14_M2_heat-set_insert
15_M2x14_countersunk_screw
16_M2_heat-set_insert
