StyNW7/Terrava/iot/ear-tag-specifications/tv-et1-shield/models/step/terrava-ear-tag-assembly.step

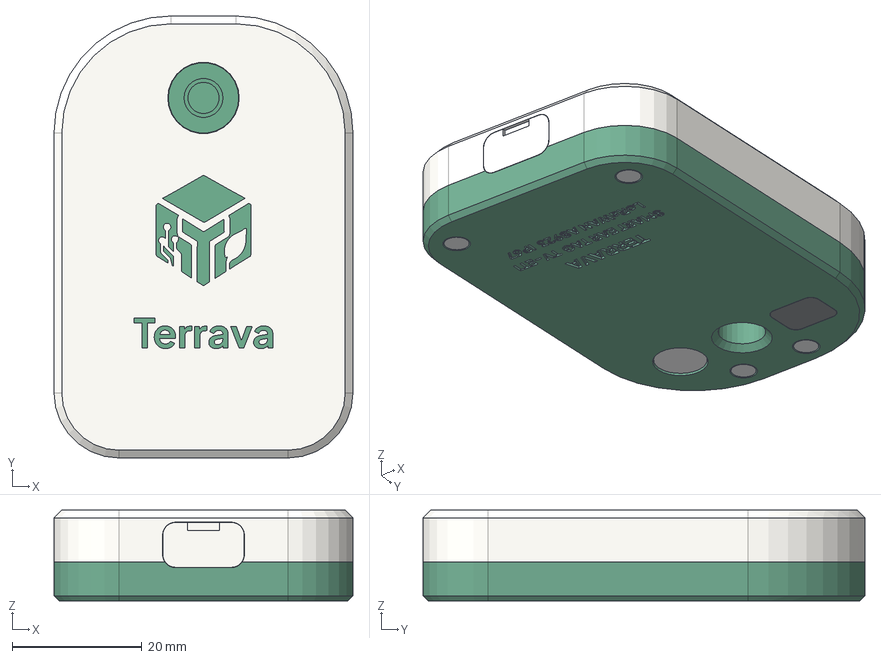
[picture p70: CAD file, 2026-10-21]
iot/ear-tag-specifications/tv-et1-shield/models/step/terrava-ear-tag-assembly.step
46.0 x 68.0 x 14.0 mm
base
cover
logo_inlay
pin_cap
lock_ring
gasket
usb_plug
ppg_window
00_Wio-SX1262_LoRa_board
01_XIAO_ESP32S3
02_ESP32-S3_shield
03_USB-C_receptacle
04_LiPo_602535_500_mAh
05_Battery_PCM
06_GNSS_ceramic_patch_18x18
07_GNSS_module_(L76K_/_ATGM336H)
08_6-axis_IMU_breakout
09_LoRa_FPC_antenna_923_MHz
10_MLX90614_IR_thermometer
11_MAX30102_PPG_sensor
12_M2x10_countersunk_screw
13_M2_heat-set_insert
14_M2x10_countersunk_screw
15_M2_heat-set_insert
16_M2x10_countersunk_screw
17_M2_heat-set_insert
18_M2x10_countersunk_screw
19_M2_heat-set_insert
