StyNW7/Terrava/iot/ear-tag-specifications/tv-et0-classic/models/step/04-pin-cap-TPU-grey.step

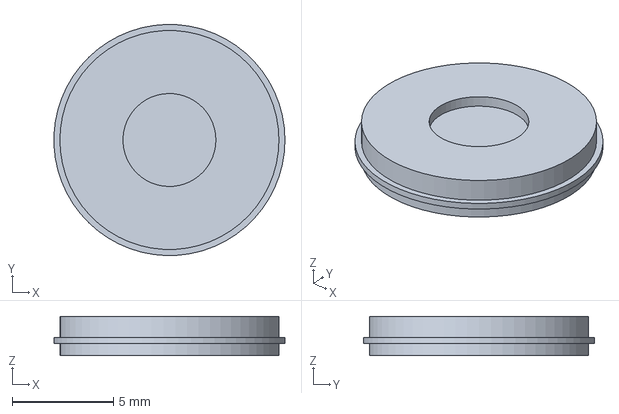
[picture p71: CAD file, 2026-10-21]
iot/ear-tag-specifications/tv-et0-classic/models/step/04-pin-cap-TPU-grey.step
11.4 x 11.4 x 1.95 mm
