StyNW7/Terrava/iot/ear-tag-specifications/tv-et0-classic/models/step/01-rear-housing.step

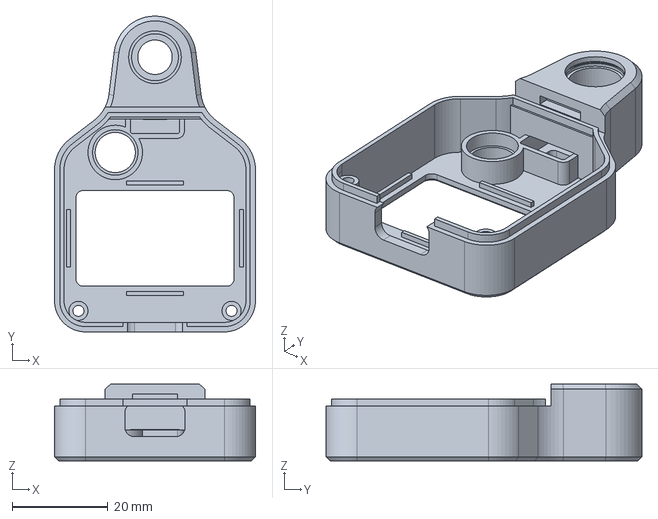
[picture p72: CAD file, 2026-10-21]
iot/ear-tag-specifications/tv-et0-classic/models/step/01-rear-housing.step
42.0 x 66.0 x 16.0 mm
