StyNW7/Terrava/iot/ear-tag-specifications/tv-et1-shield/models/step/03b-logo-inlay-press-fit.step

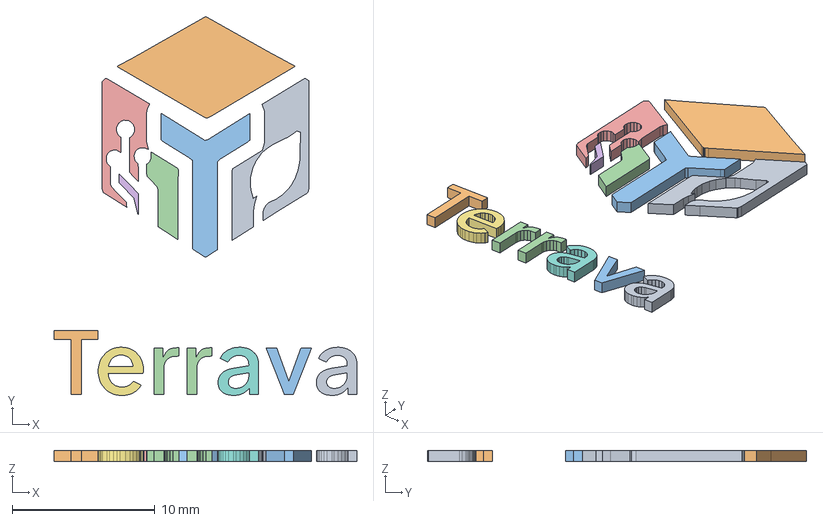
[picture p73: CAD file, 2026-10-21]
iot/ear-tag-specifications/tv-et1-shield/models/step/03b-logo-inlay-press-fit.step
21.2 x 26.6 x 0.8 mm
