StyNW7/Terrava/iot/ear-tag-specifications/tv-et0-classic/models/step/05-pin-lock-ring-TPU.step

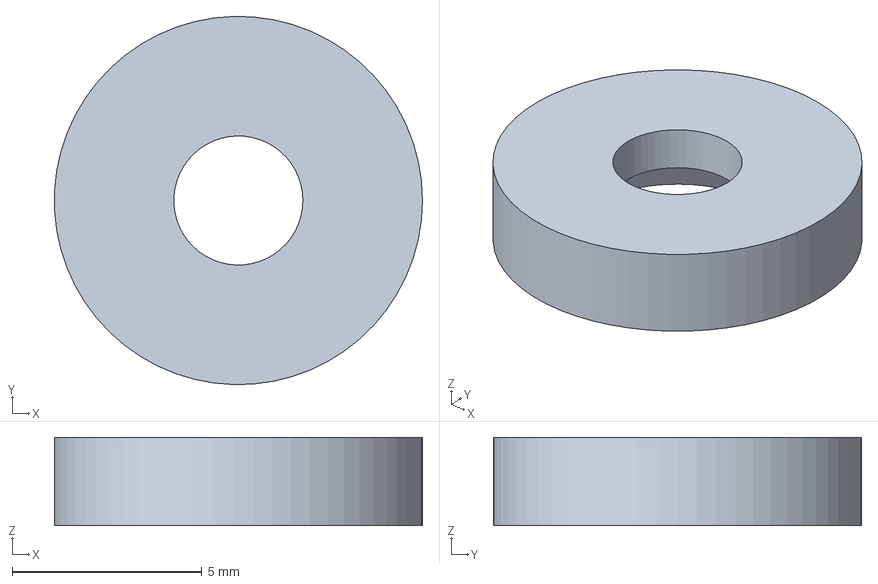
[picture p74: CAD file, 2026-10-21]
iot/ear-tag-specifications/tv-et0-classic/models/step/05-pin-lock-ring-TPU.step
9.69 x 9.70 x 2.33 mm
