StyNW7/Terrava/iot/ear-tag-specifications/tv-et1-shield/models/step/02s-front-shell-cover-solar.step

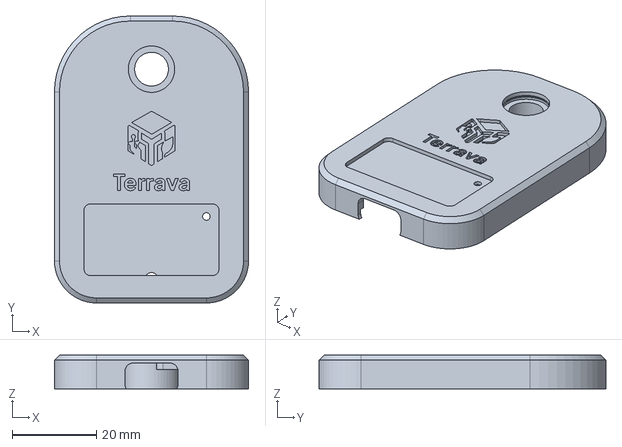
[picture p75: CAD file, 2026-10-21]
iot/ear-tag-specifications/tv-et1-shield/models/step/02s-front-shell-cover-solar.step
46.0 x 68.0 x 8.00 mm
