StyNW7/Terrava/iot/ear-tag-specifications/tv-et1-shield/models/step/05-pin-lock-ring-TPU.step

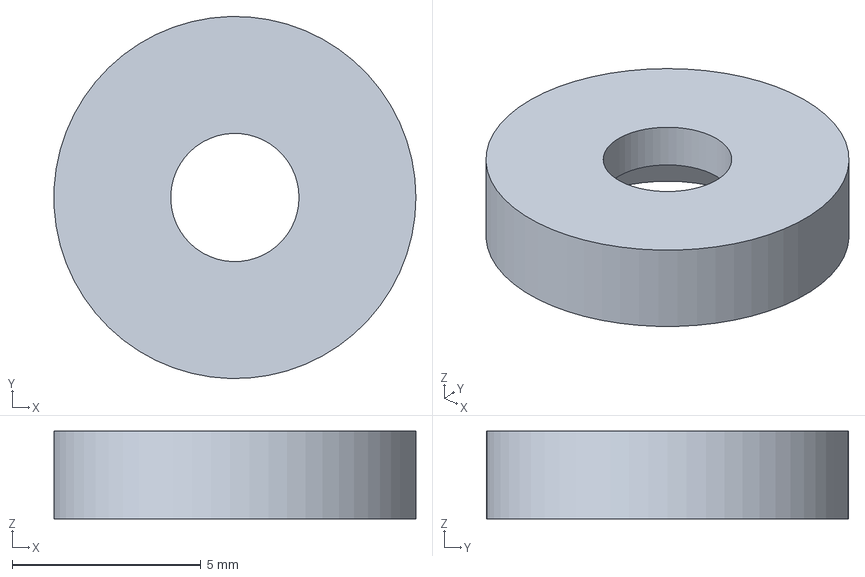
[picture p76: CAD file, 2026-10-21]
iot/ear-tag-specifications/tv-et1-shield/models/step/05-pin-lock-ring-TPU.step
9.59 x 9.60 x 2.33 mm
