StyNW7/Terrava/iot/ear-tag-specifications/tv-et0-classic/models/step/03a-logo-inlay-multimaterial.step

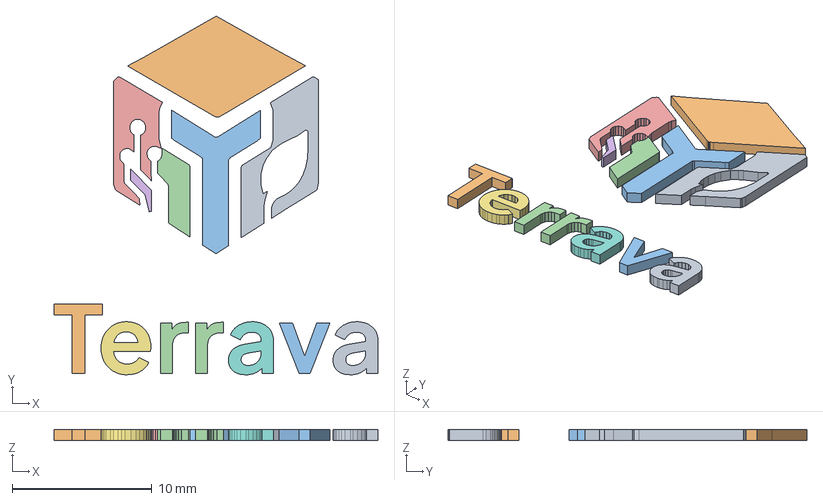
[picture p77: CAD file, 2026-10-21]
iot/ear-tag-specifications/tv-et0-classic/models/step/03a-logo-inlay-multimaterial.step
23.2 x 25.7 x 0.8 mm
