StyNW7/Terrava/iot/ear-tag-specifications/tv-et1-shield/models/step/07-usb-c-plug-TPU.step

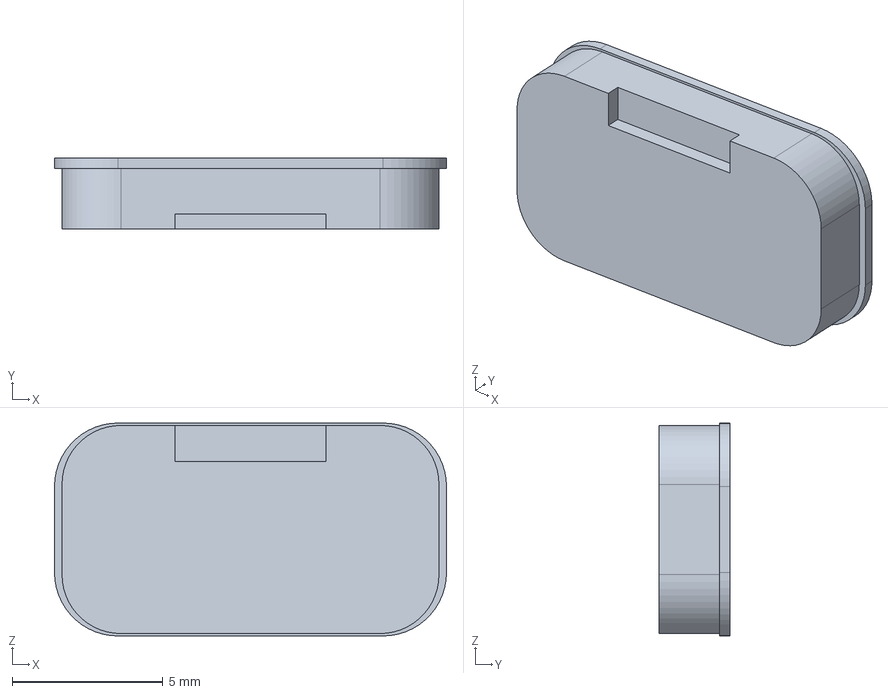
[picture p78: CAD file, 2026-10-21]
iot/ear-tag-specifications/tv-et1-shield/models/step/07-usb-c-plug-TPU.step
13.0 x 2.35 x 7.06 mm
