StyNW7/Terrava/iot/ear-tag-specifications/tv-et0-classic/models/step/06-gasket-TPU.step

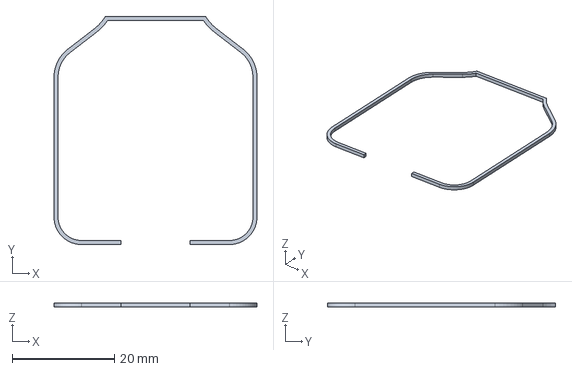
[picture p79: CAD file, 2026-10-21]
iot/ear-tag-specifications/tv-et0-classic/models/step/06-gasket-TPU.step
39.7 x 44.6 x 0.8 mm
