StyNW7/Terrava/iot/ear-tag-specifications/tv-et1-shield/models/step/08-ppg-window-clear.step

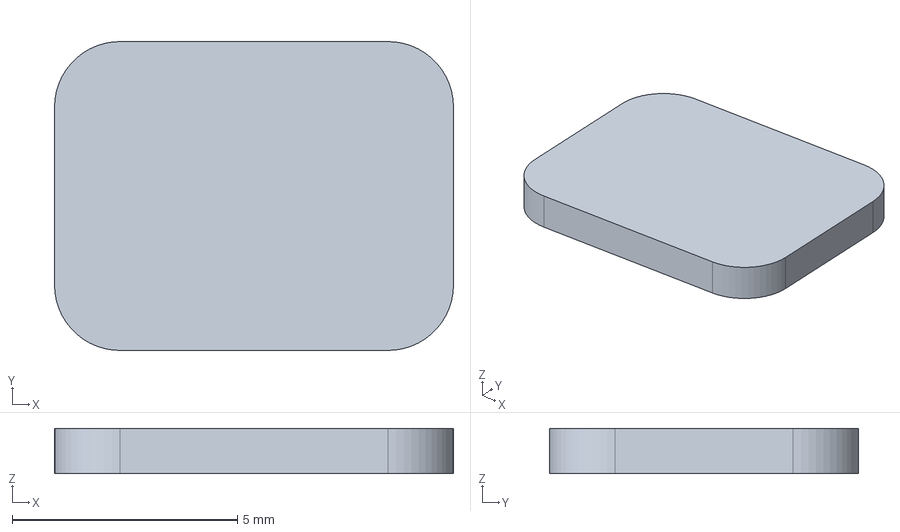
[picture p80: CAD file, 2026-10-21]
iot/ear-tag-specifications/tv-et1-shield/models/step/08-ppg-window-clear.step
8.85 x 6.85 x 1.00 mm
