StyNW7/Terrava/iot/ear-tag-specifications/tv-et1-shield/models/step/06-gasket-TPU.step

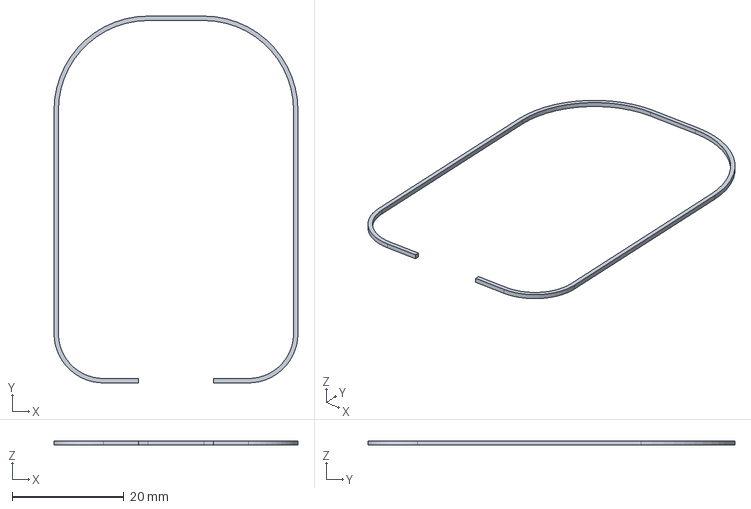
[picture p81: CAD file, 2026-10-21]
iot/ear-tag-specifications/tv-et1-shield/models/step/06-gasket-TPU.step
43.7 x 65.7 x 0.8 mm
