StyNW7/Terrava/iot/ear-tag-specifications/tv-et0-classic/models/step/03b-logo-inlay-press-fit.step

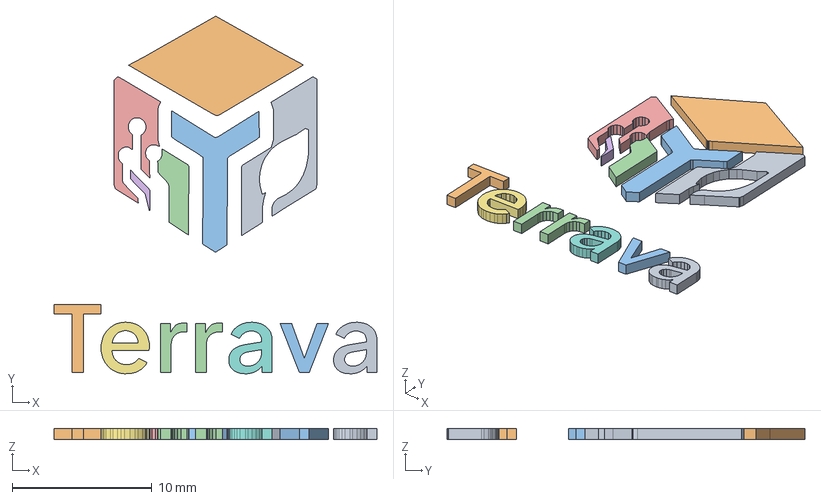
[picture p82: CAD file, 2026-10-21]
iot/ear-tag-specifications/tv-et0-classic/models/step/03b-logo-inlay-press-fit.step
23.1 x 25.6 x 0.8 mm
