StyNW7/Terrava/iot/ear-tag-specifications/tv-et0-classic/models/step/09-sensor-yoke-TPU-grey.step

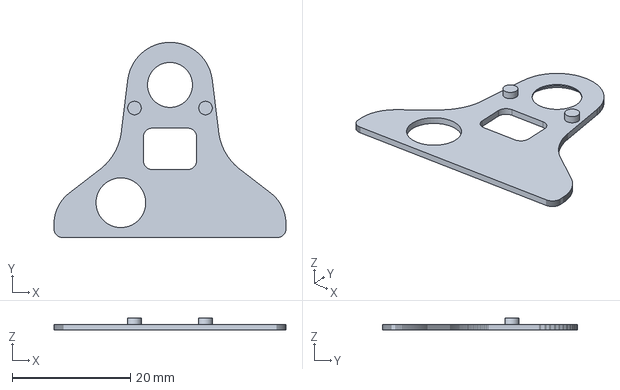
[picture p83: CAD file, 2026-10-21]
iot/ear-tag-specifications/tv-et0-classic/models/step/09-sensor-yoke-TPU-grey.step
39.2 x 33.0 x 2.10 mm
