StyNW7/Terrava/iot/ear-tag-specifications/tv-et1-shield/models/step/03a-logo-inlay-multimaterial.step

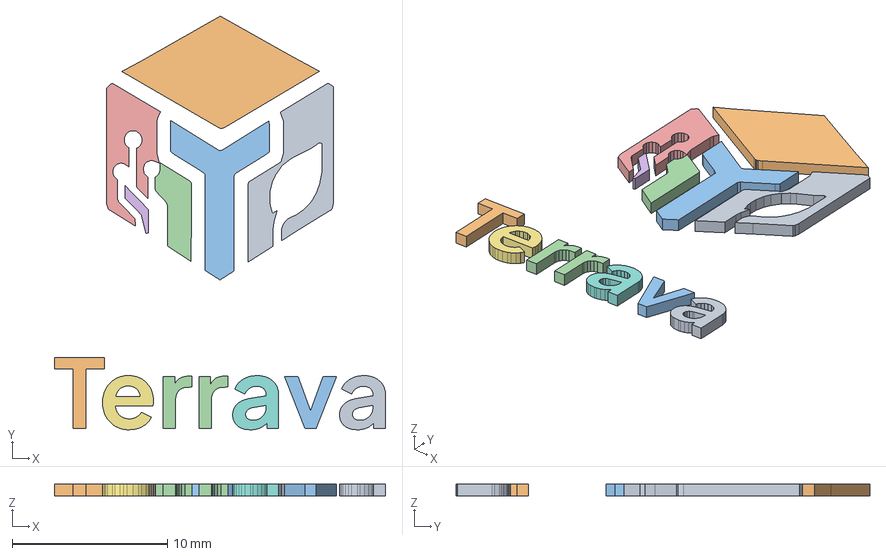
[picture p84: CAD file, 2026-10-21]
iot/ear-tag-specifications/tv-et1-shield/models/step/03a-logo-inlay-multimaterial.step
21.3 x 26.7 x 0.8 mm
