StyNW7/Terrava/iot/ear-tag-specifications/tv-et0-classic/models/step/08-ppg-window-clear.step

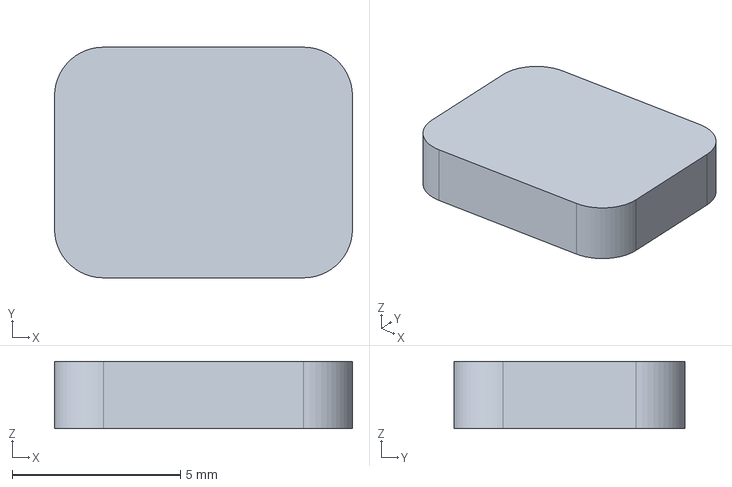
[picture p85: CAD file, 2026-10-21]
iot/ear-tag-specifications/tv-et0-classic/models/step/08-ppg-window-clear.step
8.85 x 6.85 x 2.00 mm
