StyNW7/Terrava/iot/ear-tag-specifications/tv-et1-shield/models/step/01-rear-shell-base.step

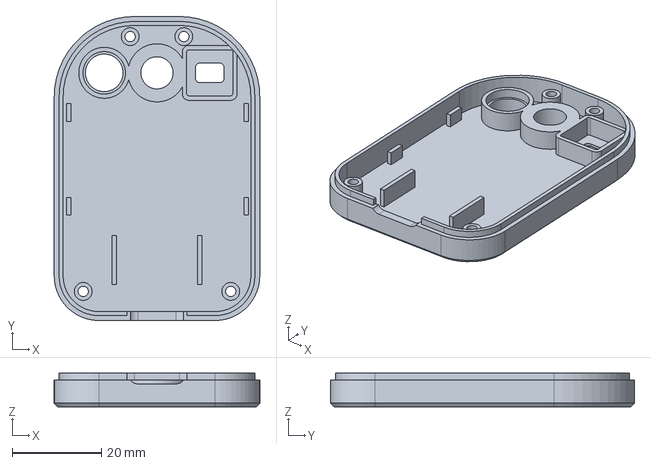
[picture p86: CAD file, 2026-10-21]
iot/ear-tag-specifications/tv-et1-shield/models/step/01-rear-shell-base.step
46.0 x 68.0 x 7.50 mm
