StyNW7/Terrava/iot/ear-tag-specifications/tv-et0-classic/models/step/02-front-cover.step

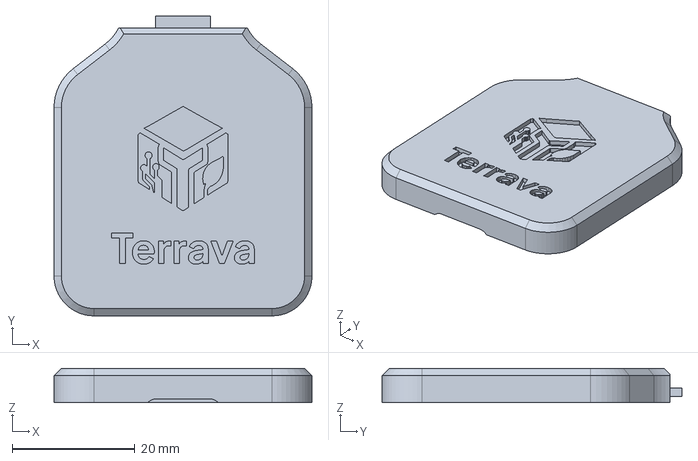
[picture p87: CAD file, 2026-10-21]
iot/ear-tag-specifications/tv-et0-classic/models/step/02-front-cover.step
42.0 x 48.8 x 5.60 mm
