StyNW7/Terrava/iot/ear-tag-specifications/tv-et1-shield/models/step/03s-logo-inlay-solar-multimaterial.step

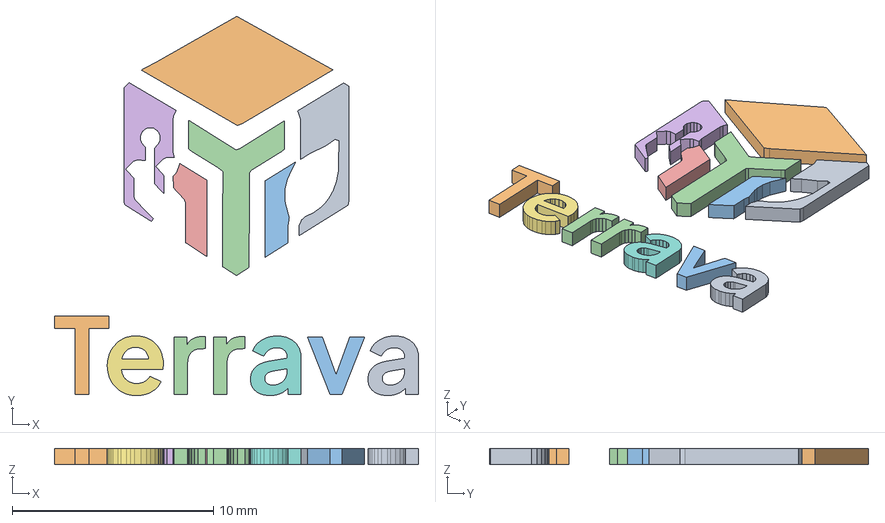
[picture p88: CAD file, 2026-10-21]
iot/ear-tag-specifications/tv-et1-shield/models/step/03s-logo-inlay-solar-multimaterial.step
18.1 x 18.9 x 0.8 mm
