StyNW7/Terrava/(list of files, cad)

Other CAD files:
iot/ear-tag-specifications/tv-et1-shield/models/step/04-pin-cap-TPU.step
iot/ear-tag-specifications/tv-et0-classic/models/step/07-usb-c-plug-TPU.step
iot/ear-tag-specifications/tv-et1-shield/models/step/02-front-shell-cover.step
iot/ear-tag-specifications/tv-et0-classic/models/stl/01-rear-housing.stl
iot/ear-tag-specifications/tv-et0-classic/models/stl/02-front-cover.stl
iot/ear-tag-specifications/tv-et0-classic/models/stl/03a-logo-inlay-multimaterial.stl
iot/ear-tag-specifications/tv-et0-classic/models/stl/03b-logo-inlay-press-fit.stl
iot/ear-tag-specifications/tv-et0-classic/models/stl/04-pin-cap-TPU-grey.stl
iot/ear-tag-specifications/tv-et0-classic/models/stl/05-pin-lock-ring-TPU.stl
iot/ear-tag-specifications/tv-et0-classic/models/stl/06-gasket-TPU.stl
iot/ear-tag-specifications/tv-et0-classic/models/stl/07-usb-c-plug-TPU.stl
iot/ear-tag-specifications/tv-et0-classic/models/stl/08-ppg-window-clear.stl
iot/ear-tag-specifications/tv-et0-classic/models/stl/09-sensor-yoke-TPU-grey.stl
iot/ear-tag-specifications/tv-et1-shield/models/stl/01-rear-shell-base.stl
iot/ear-tag-specifications/tv-et1-shield/models/stl/02-front-shell-cover.stl
iot/ear-tag-specifications/tv-et1-shield/models/stl/02s-front-shell-cover-solar.stl
iot/ear-tag-specifications/tv-et1-shield/models/stl/03a-logo-inlay-multimaterial.stl
iot/ear-tag-specifications/tv-et1-shield/models/stl/03b-logo-inlay-press-fit.stl
iot/ear-tag-specifications/tv-et1-shield/models/stl/03s-logo-inlay-solar-multimaterial.stl
iot/ear-tag-specifications/tv-et1-shield/models/stl/04-pin-cap-TPU.stl
iot/ear-tag-specifications/tv-et1-shield/models/stl/05-pin-lock-ring-TPU.stl
iot/ear-tag-specifications/tv-et1-shield/models/stl/06-gasket-TPU.stl
iot/ear-tag-specifications/tv-et1-shield/models/stl/07-usb-c-plug-TPU.stl
iot/ear-tag-specifications/tv-et1-shield/models/stl/08-ppg-window-clear.stl
