StyNW7/Terrava/iot/ear-tag-specifications/tv-et0-classic/images/drawings/sheet-3-placement-installation.pdf

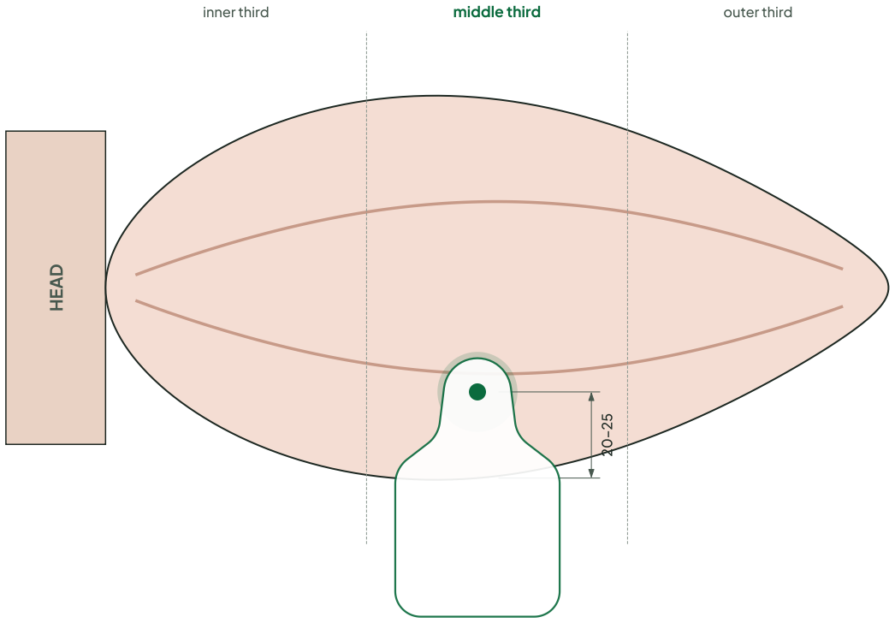
[picture p89: figure]
HEAD; inner third; middle third; outer third

Pin in the middle third, below the lower cartilage rib, 20–25 mm above the

lower ear margin: the yoke rests on the ear, the solar half hangs free below it.

## 1 · WHERE

inside (front) face of the ear, scale 1 : 1.8

## 2 · HOW IT HOLDS

side section through the pin, scale 2 : 1

ear
3–8 mm

male button
(standard)

Terrava Classic neck

## 3 · PLUG & USE IN SIX STEPS

1

### Charge

USB-C on the bottom edge; full in ~1.5 h (250 mAh).

2

## Seal

Press the TPU plug into the port until flush; check the gasket seam.

3

### Register

Terrava dashboard → Devices → add DevEUI, pair with the animal.

4

### Load

Cap off. Neck on the applicator's female spike, male button on the pin.

5

### Apply

Logo out, yoke to the ear, 20–25 mm above the lower margin; one stroke.

6

### Cap & go

Snap the grey cap in. Reports within 5 min; the sun tops it up.

TPU lock ring grips the arrow tip

grey cap hides the tip

soft TPU yoke against the skin: PPG + IR sensors look out here

# Terrava

### SMART EAR TAG · TV-ET0 CLASSIC

# Placement & installation

Use with standard two-piece male buttons (pin ≈ 19 mm) · Re-tagging: cut the pin, replace the lock ring

UNITS

mm

SCALE

### as noted

TOLERANCE

### ±0.2 unless noted

REV

A

DATE

2026-10-21

SHEET

3 / 3
