StyNW7/Terrava/iot/ear-tag-specifications/tv-et1-shield/images/drawings/sheet-3-placement-installation.pdf

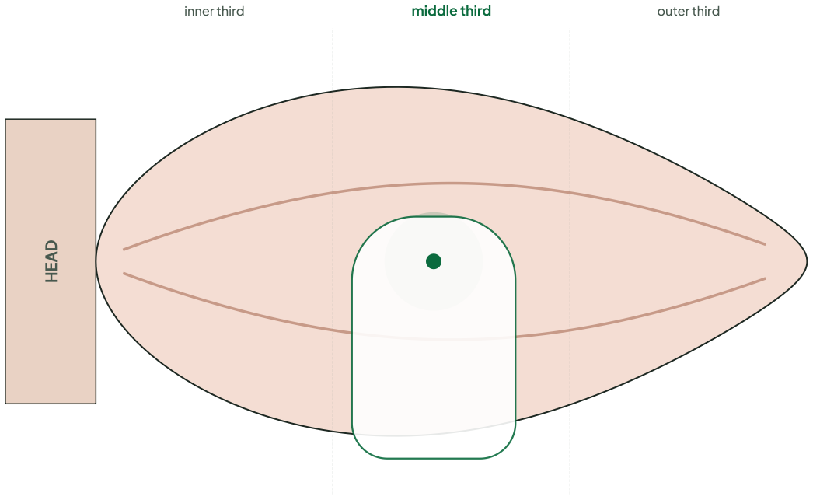
[picture p90: figure]
HEAD; inner third; middle third; outer third

Pin between the two cartilage ribs, in the middle third of the ear. Avoid the large veins (hold the ear to the light) and the ear edge.

## 1 · WHERE

inside (front) face of the ear, scale 1 : 1.8

## 2 · HOW IT HOLDS

side section through the pin, scale 2 : 1

## 3 · PLUG & USE IN SIX STEPS

1

### Charge

Plug USB-C, the status light glows through the shell. Full in ~2 h.

2

## Seal

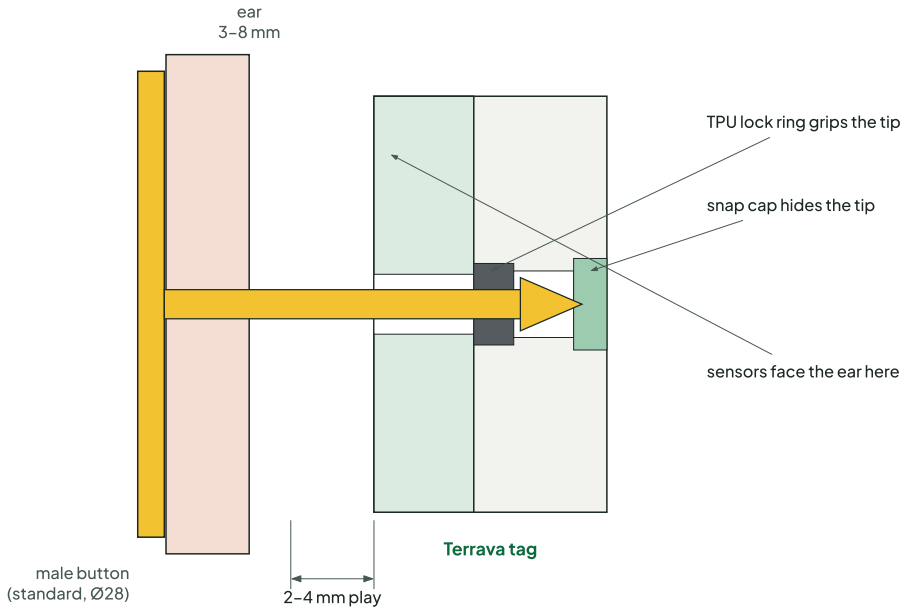
[picture p91: figure]
ear 3–8 mm; male button (standard, Ø28); Terrava tag; 2–4 mm play; TPU lock ring grips the tip; snap cap hides the tip; sensors face the ear here

Press the TPU plug into the port until flush; check the gasket seam.

3

### Register

Terrava dashboard → Devices → add DevEUI, pair with the animal.

4

### Load

Cap off. Tag on the applicator's female jaw, male button on the pin.

5

### Apply

Disinfect, squeeze in one firm stroke at the marked zone.

6

### Cap & go

Snap the cap in. The tag joins LoRaWAN and reports within 5 min.

# Terrava

### SMART EAR TAG · TV-ET1

# Placement & installation

Use with standard two-piece male buttons (pin ≈ 19 mm) · Re-tagging: cut the pin, replace the lock ring

UNITS

mm

SCALE

### as noted

TOLERANCE

### ±0.2 unless noted

REV

A

DATE

2026-10-21

SHEET

3 / 3
