StyNW7/Terrava/iot/ear-tag-specifications/tv-et0-classic/images/drawings/sheet-3-placement-installation.png

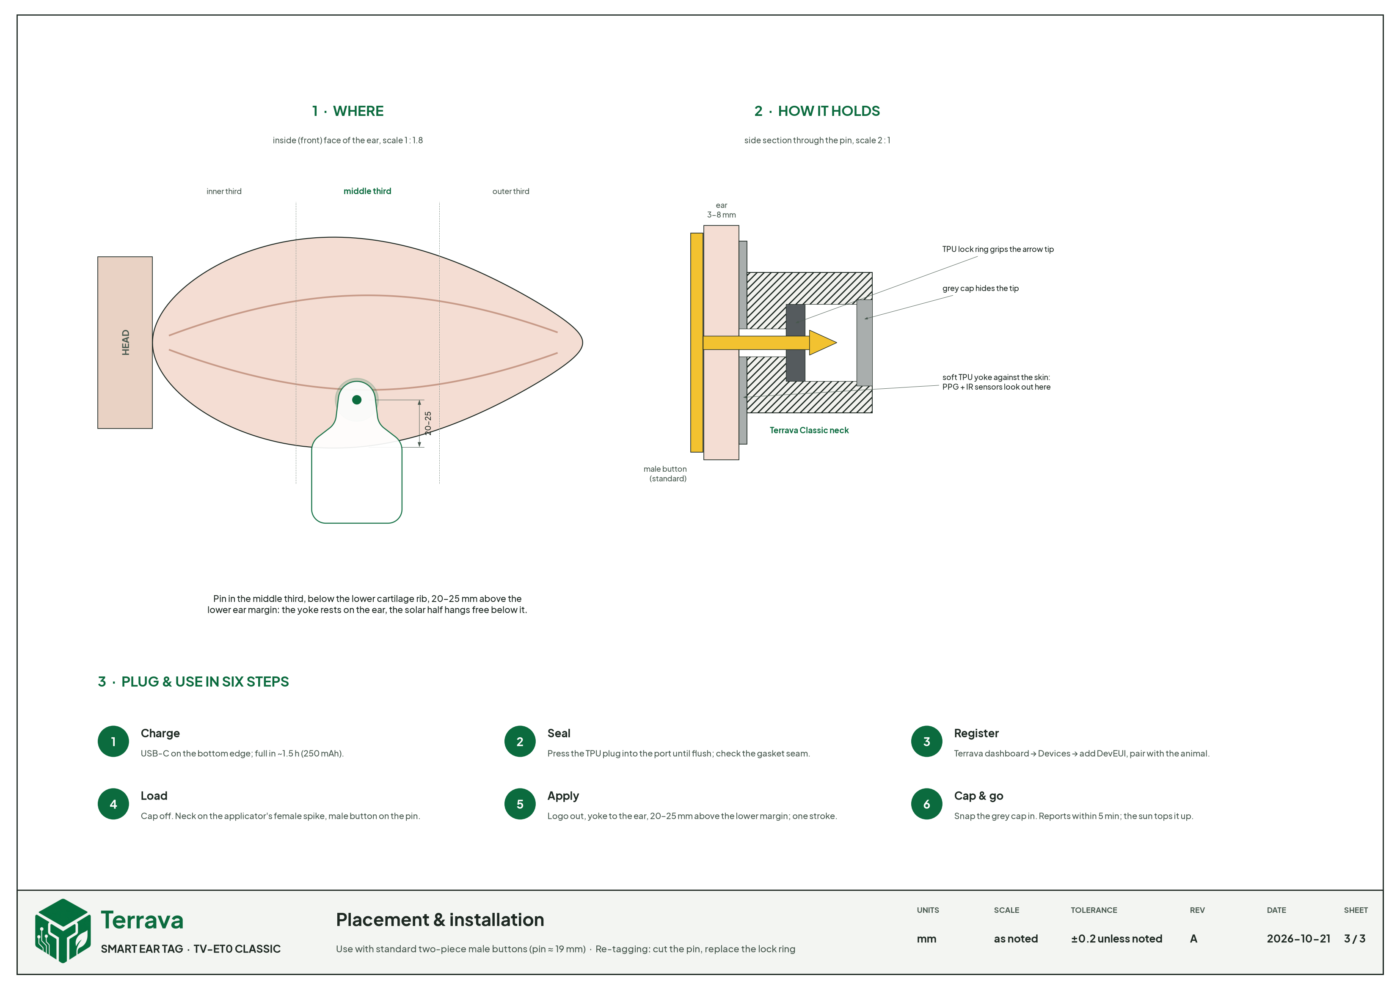
iot/ear-tag-specifications/tv-et0-classic/images/drawings/sheet-3-placement-installation.png
