StyNW7/Terrava/iot/ear-tag-specifications/tv-et0-classic/images/drawings/sheet-1-general-arrangement.pdf

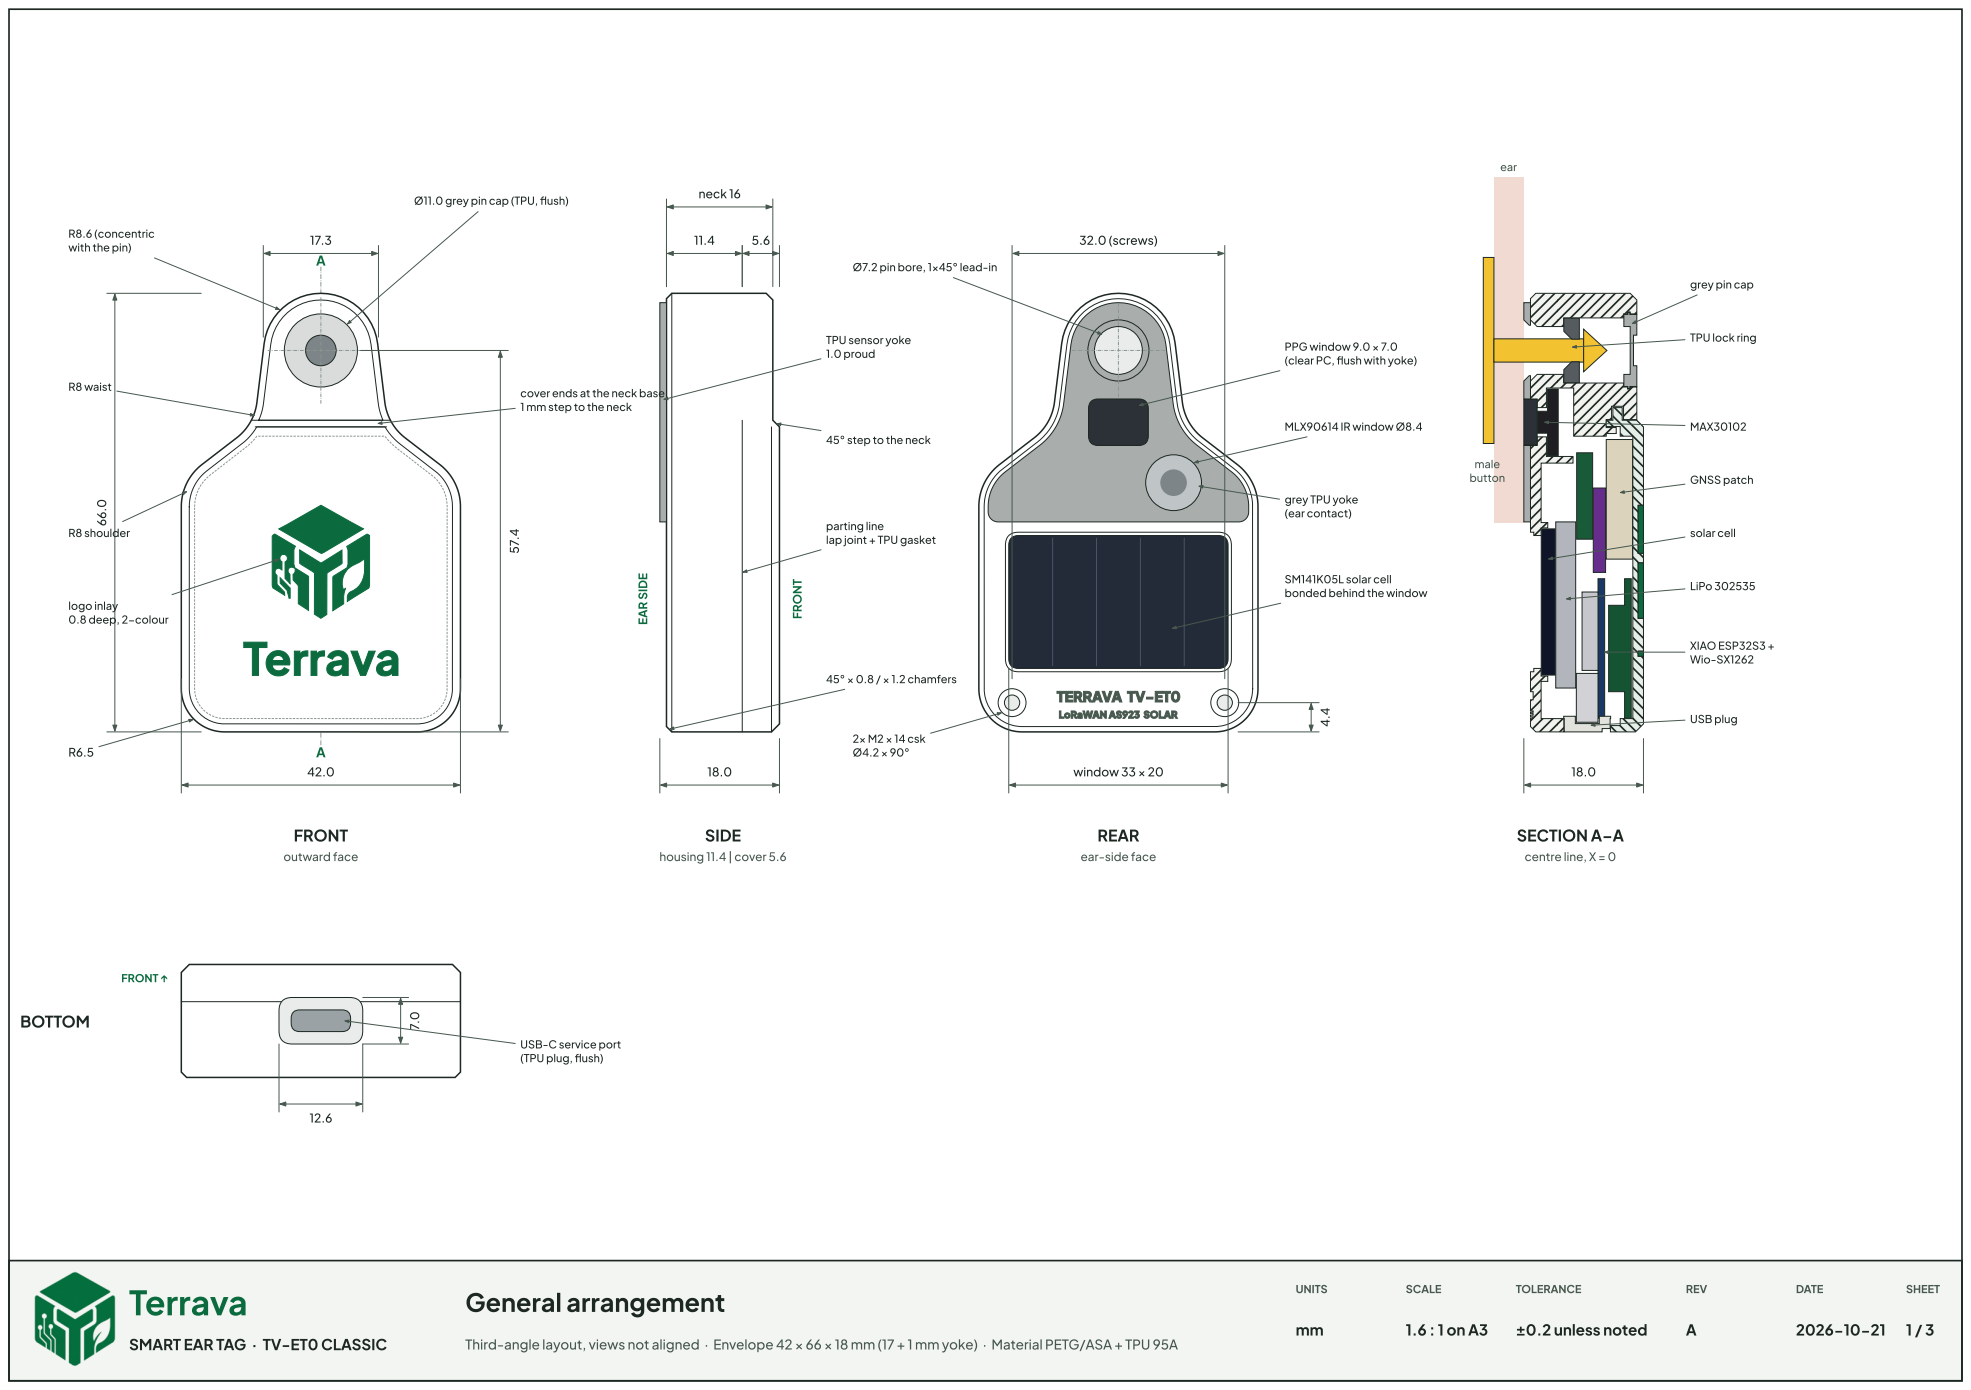
[picture p93: page 1]
FRONT; outward face; EAR SIDE; SIDE; housing 11.4 | cover 5.6; REAR; FRONT ↑; BOTTOM; ear; male button; SECTION A–A; centre line, X = 0; neck 16; window 33 × 20; 32.0 (screws); R8 shoulder; R8 waist; logo inlay 0.8 deep, 2-colour; 45° × 0.8 / × 1.2 chamfers; MLX90614 IR window Ø8.4; 2× M2 × 14 csk Ø4.2 × 90°; XIAO ESP32S3 + Wio-SX1262; LiPo 302535; solar cell; GNSS patch; MAX30102; USB plug; Terrava; General arrangement; UNITS; SCALE; TOLERANCE; ±0.2 unless noted; REV; DATE; SHEET

Ø11.0 grey pin cap (TPU, flush)

R8.6 (concentric
with the pin)

Ø7.2 pin bore, 1×45° lead-in

grey pin cap

TPU sensor yoke
1.0 proud

PPG window 9.0 × 7.0
(clear PC, flush with yoke)

TPU lock ring

cover ends at the neck base,
1 mm step to the neck

45° step to the neck

grey TPU yoke
(ear contact)

parting line
lap joint + TPU gasket

SM141K05L solar cell
bonded behind the window

ear-side face

USB-C service port
(TPU plug, flush)

SMART EAR TAG · TV-ET0 CLASSIC

Third-angle layout, views not aligned · Envelope 42 × 66 × 18 mm (17 + 1 mm yoke) · Material PETG/ASA + TPU 95A
