StyNW7/Terrava/iot/ear-tag-specifications/tv-et0-classic/images/drawings/sheet-2-internal-layout.pdf

D–D

B–B

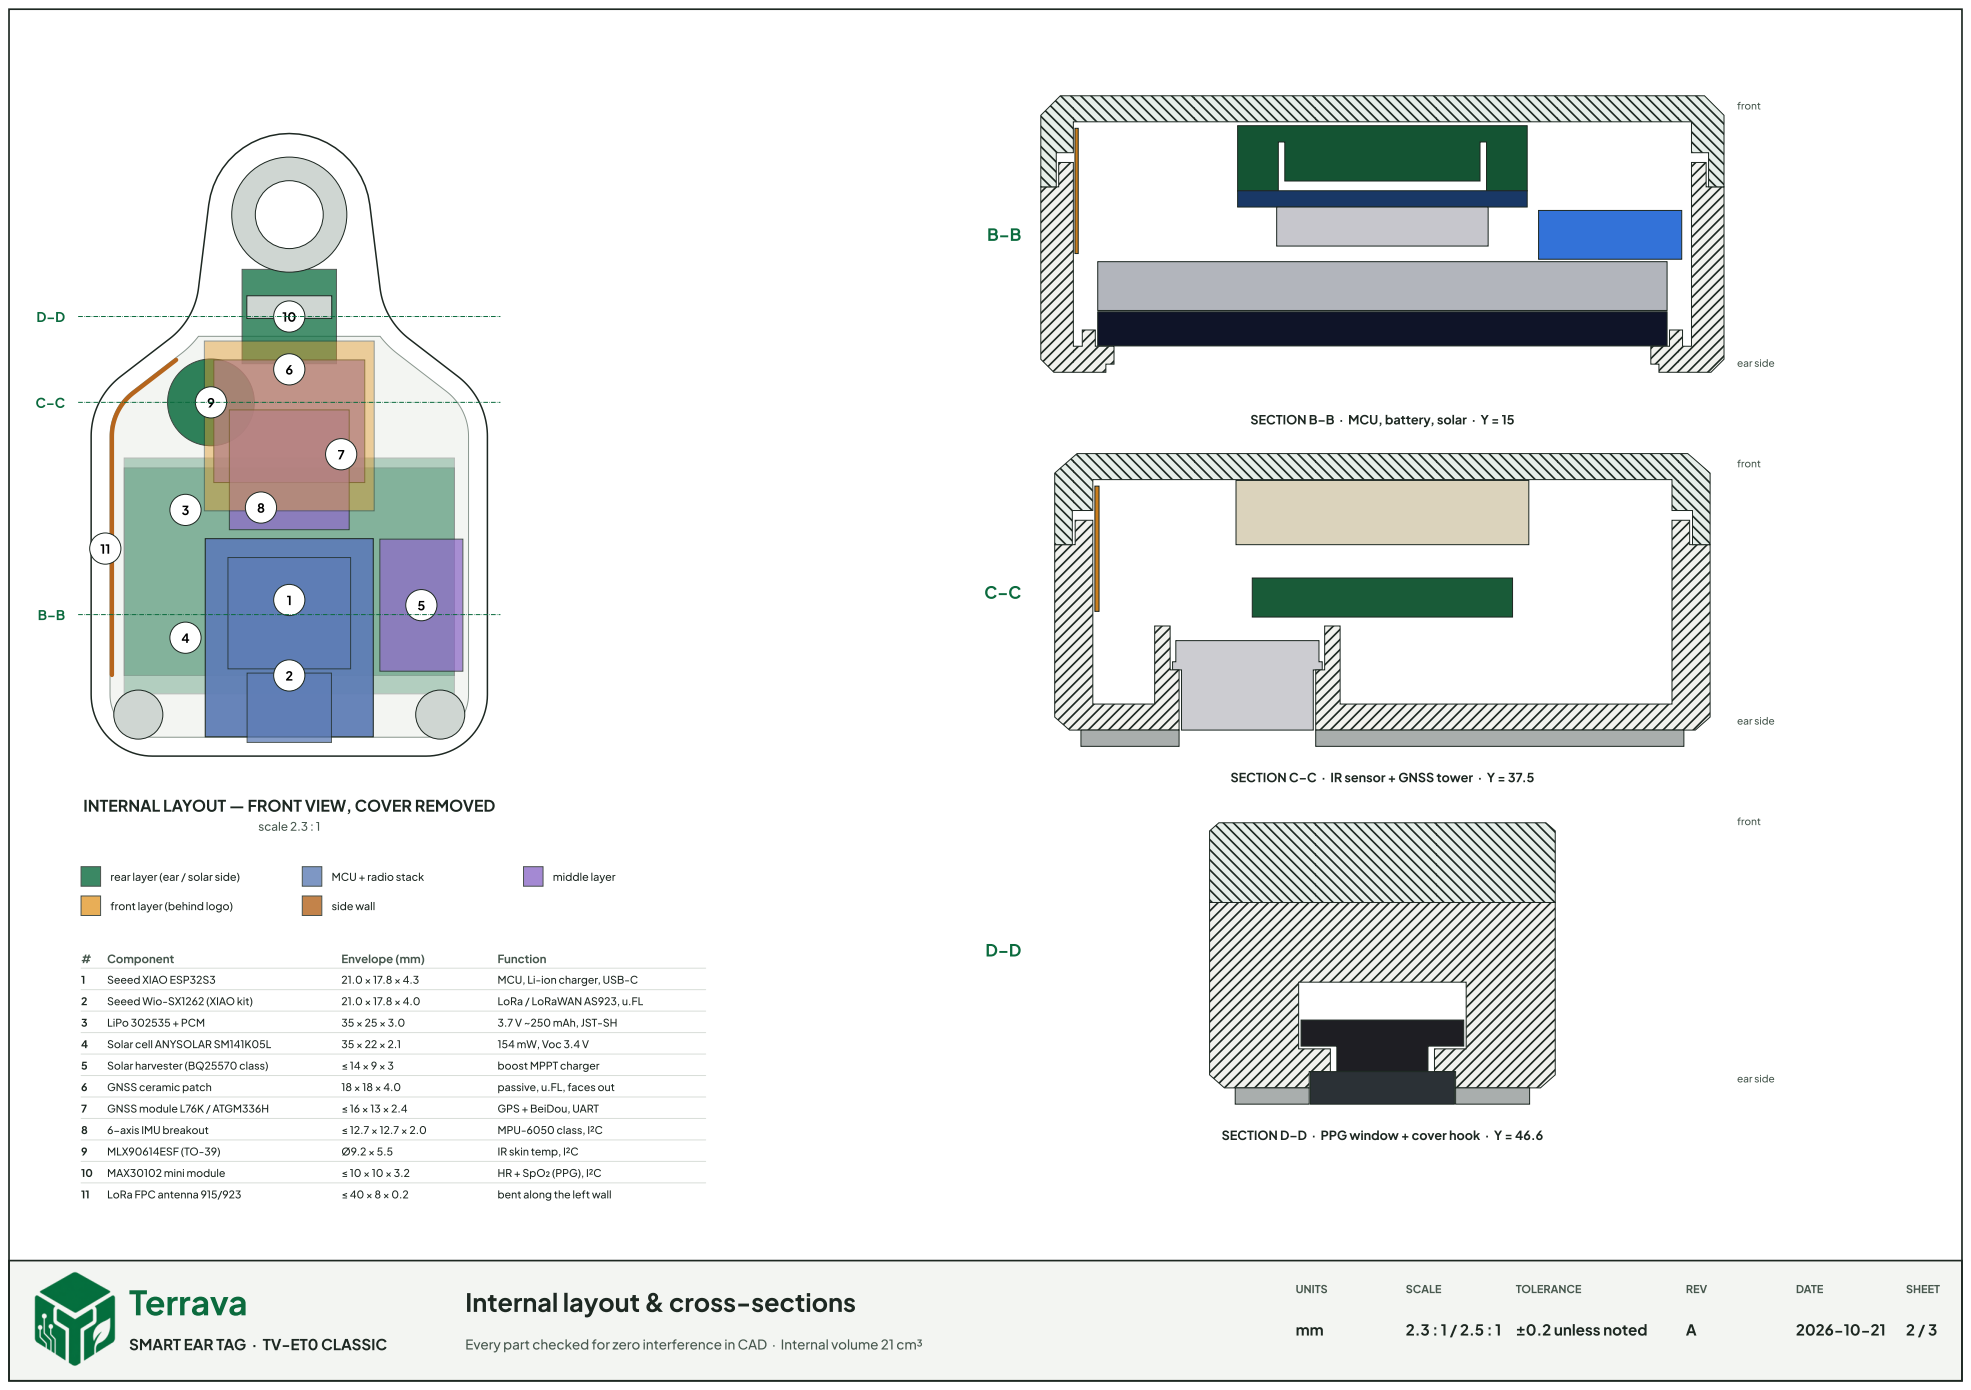
[picture p94: page 1]
scale 2.3 : 1; rear layer (ear / solar side); MCU + radio stack; middle layer; front layer (behind logo); side wall; Component; Envelope (mm); Function; Seeed XIAO ESP32S3; MCU, Li-ion charger, USB-C; Seeed Wio-SX1262 (XIAO kit); LoRa / LoRaWAN AS923, u.FL; LiPo 302535 + PCM; 3.7 V ~250 mAh, JST-SH; Solar cell ANYSOLAR SM141K05L; 154 mW, Voc 3.4 V; Solar harvester (BQ25570 class); boost MPPT charger; GNSS ceramic patch; passive, u.FL, faces out; GNSS module L76K / ATGM336H; GPS + BeiDou, UART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

SECTION B–B · MCU, battery, solar · Y = 15

SECTION C–C · IR sensor + GNSS tower · Y = 37.5

INTERNAL LAYOUT — FRONT VIEW, COVER REMOVED

SECTION D–D · PPG window + cover hook · Y = 46.6

Internal layout & cross-sections

SMART EAR TAG · TV-ET0 CLASSIC

Every part checked for zero interference in CAD · Internal volume 21 cm³
