StyNW7/Terrava/iot/ear-tag-specifications/tv-et1-shield/images/drawings/sheet-1-general-arrangement.pdf

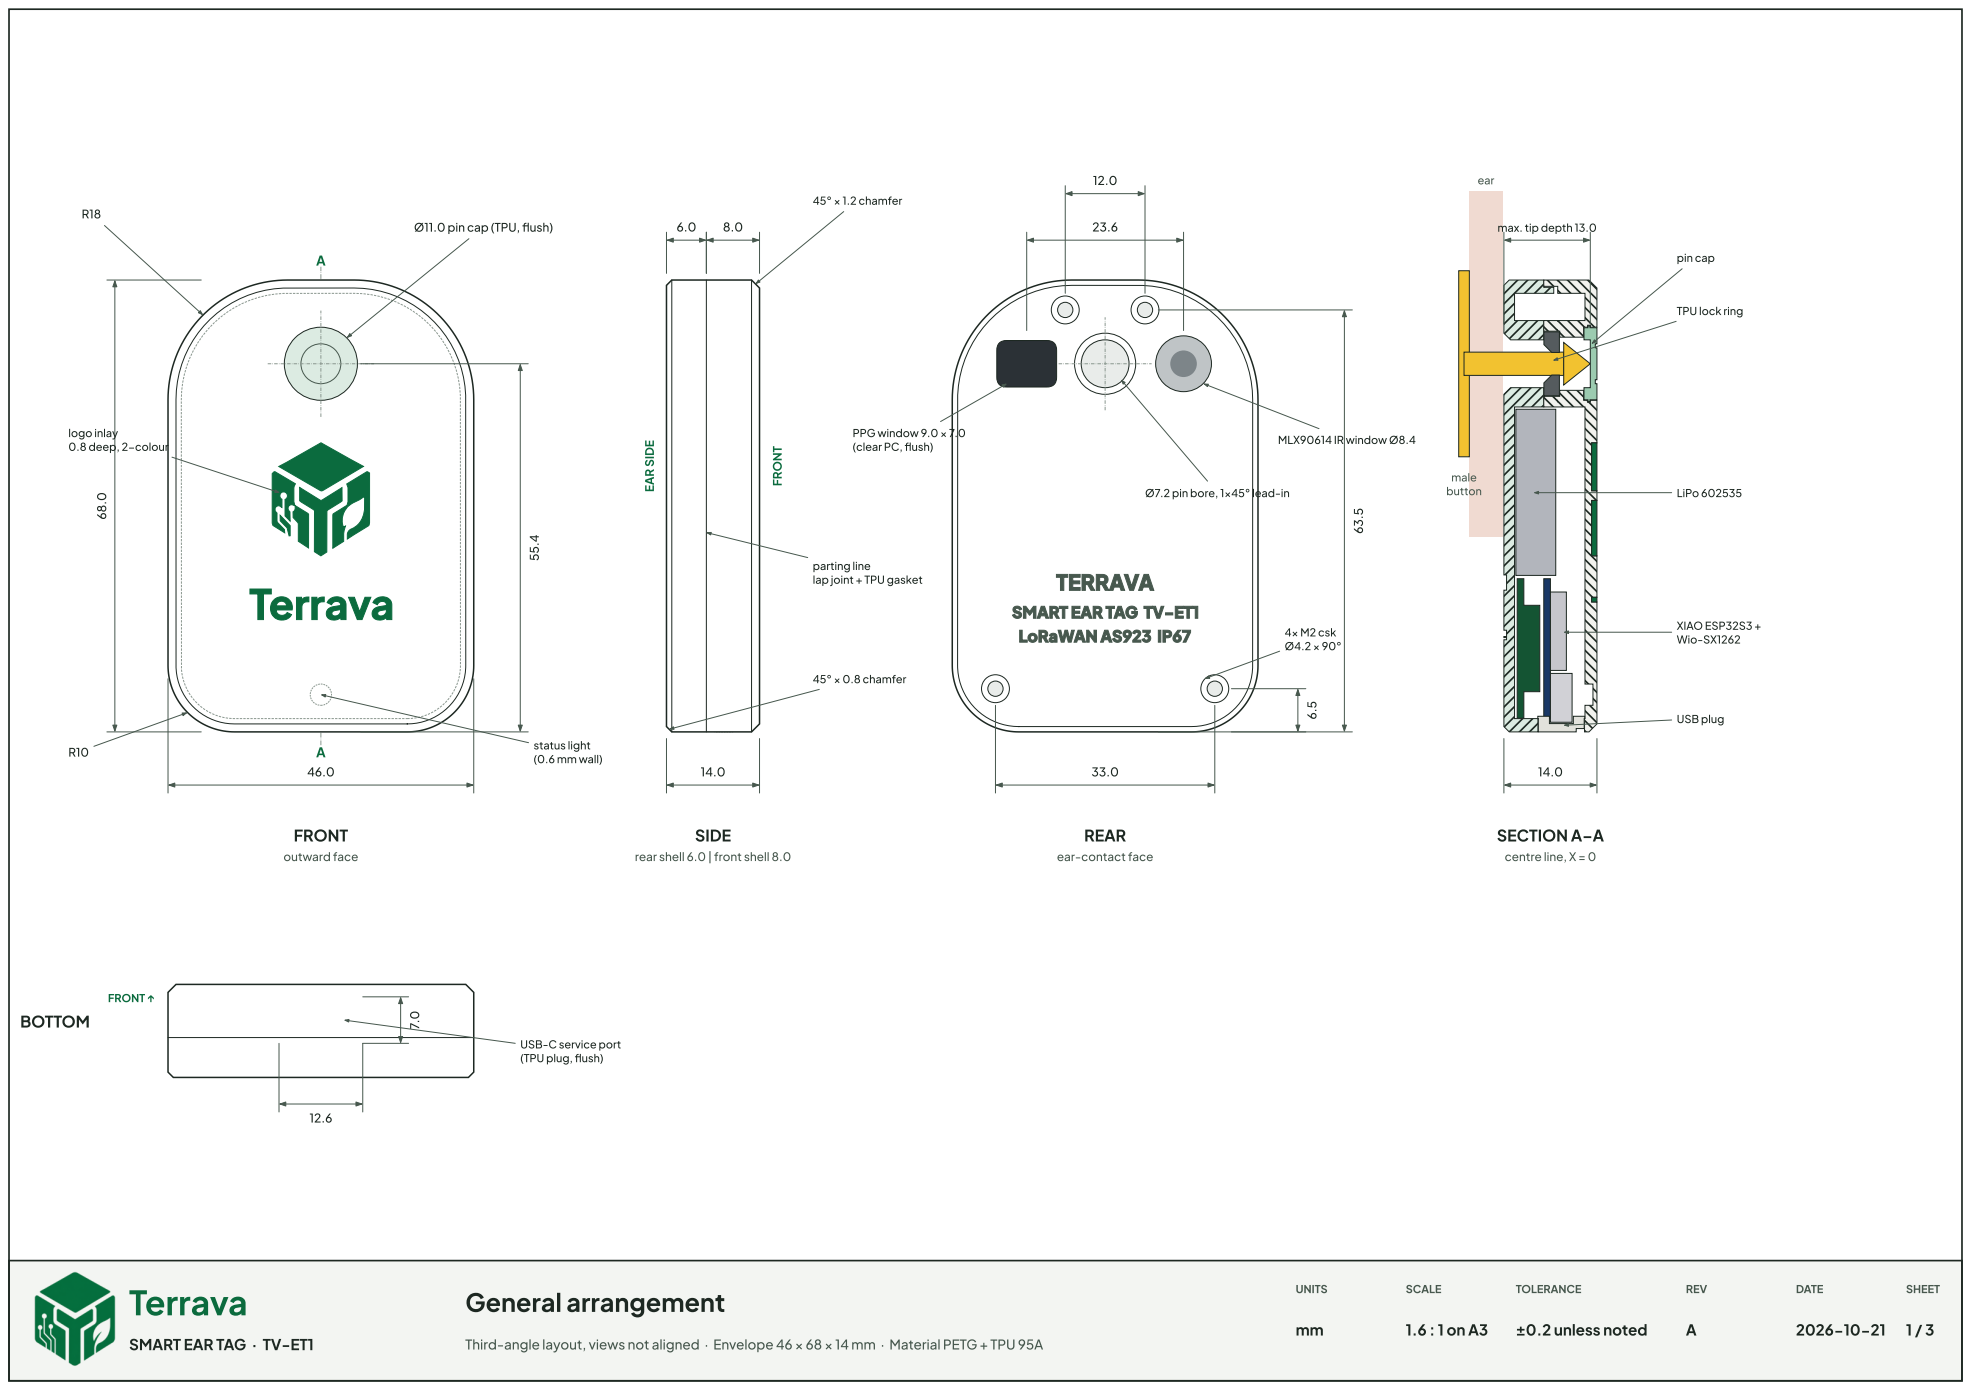
[picture p95: page 1]
FRONT; outward face; EAR SIDE; SIDE; REAR; FRONT ↑; BOTTOM; ear; male button; SECTION A–A; centre line, X = 0; status light (0.6 mm wall); logo inlay 0.8 deep, 2-colour; 45° × 1.2 chamfer; 45° × 0.8 chamfer; 4× M2 csk Ø4.2 × 90°; XIAO ESP32S3 + Wio-SX1262; LiPo 602535; pin cap; USB plug; Terrava; General arrangement; UNITS; SCALE; TOLERANCE; ±0.2 unless noted; REV; DATE; SHEET

Ø11.0 pin cap (TPU, flush)

max. tip depth 13.0

TPU lock ring

MLX90614 IR window Ø8.4 PPG window 9.0 × 7.0
(clear PC, flush)

Ø7.2 pin bore, 1×45° lead-in

parting line
lap joint + TPU gasket

rear shell 6.0 | front shell 8.0

ear-contact face

USB-C service port
(TPU plug, flush)

SMART EAR TAG · TV-ET1

Third-angle layout, views not aligned · Envelope 46 × 68 × 14 mm · Material PETG + TPU 95A
