StyNW7/Terrava/iot/ear-tag-specifications/tv-et1-shield/images/drawings/sheet-2-internal-layout.pdf

B–B

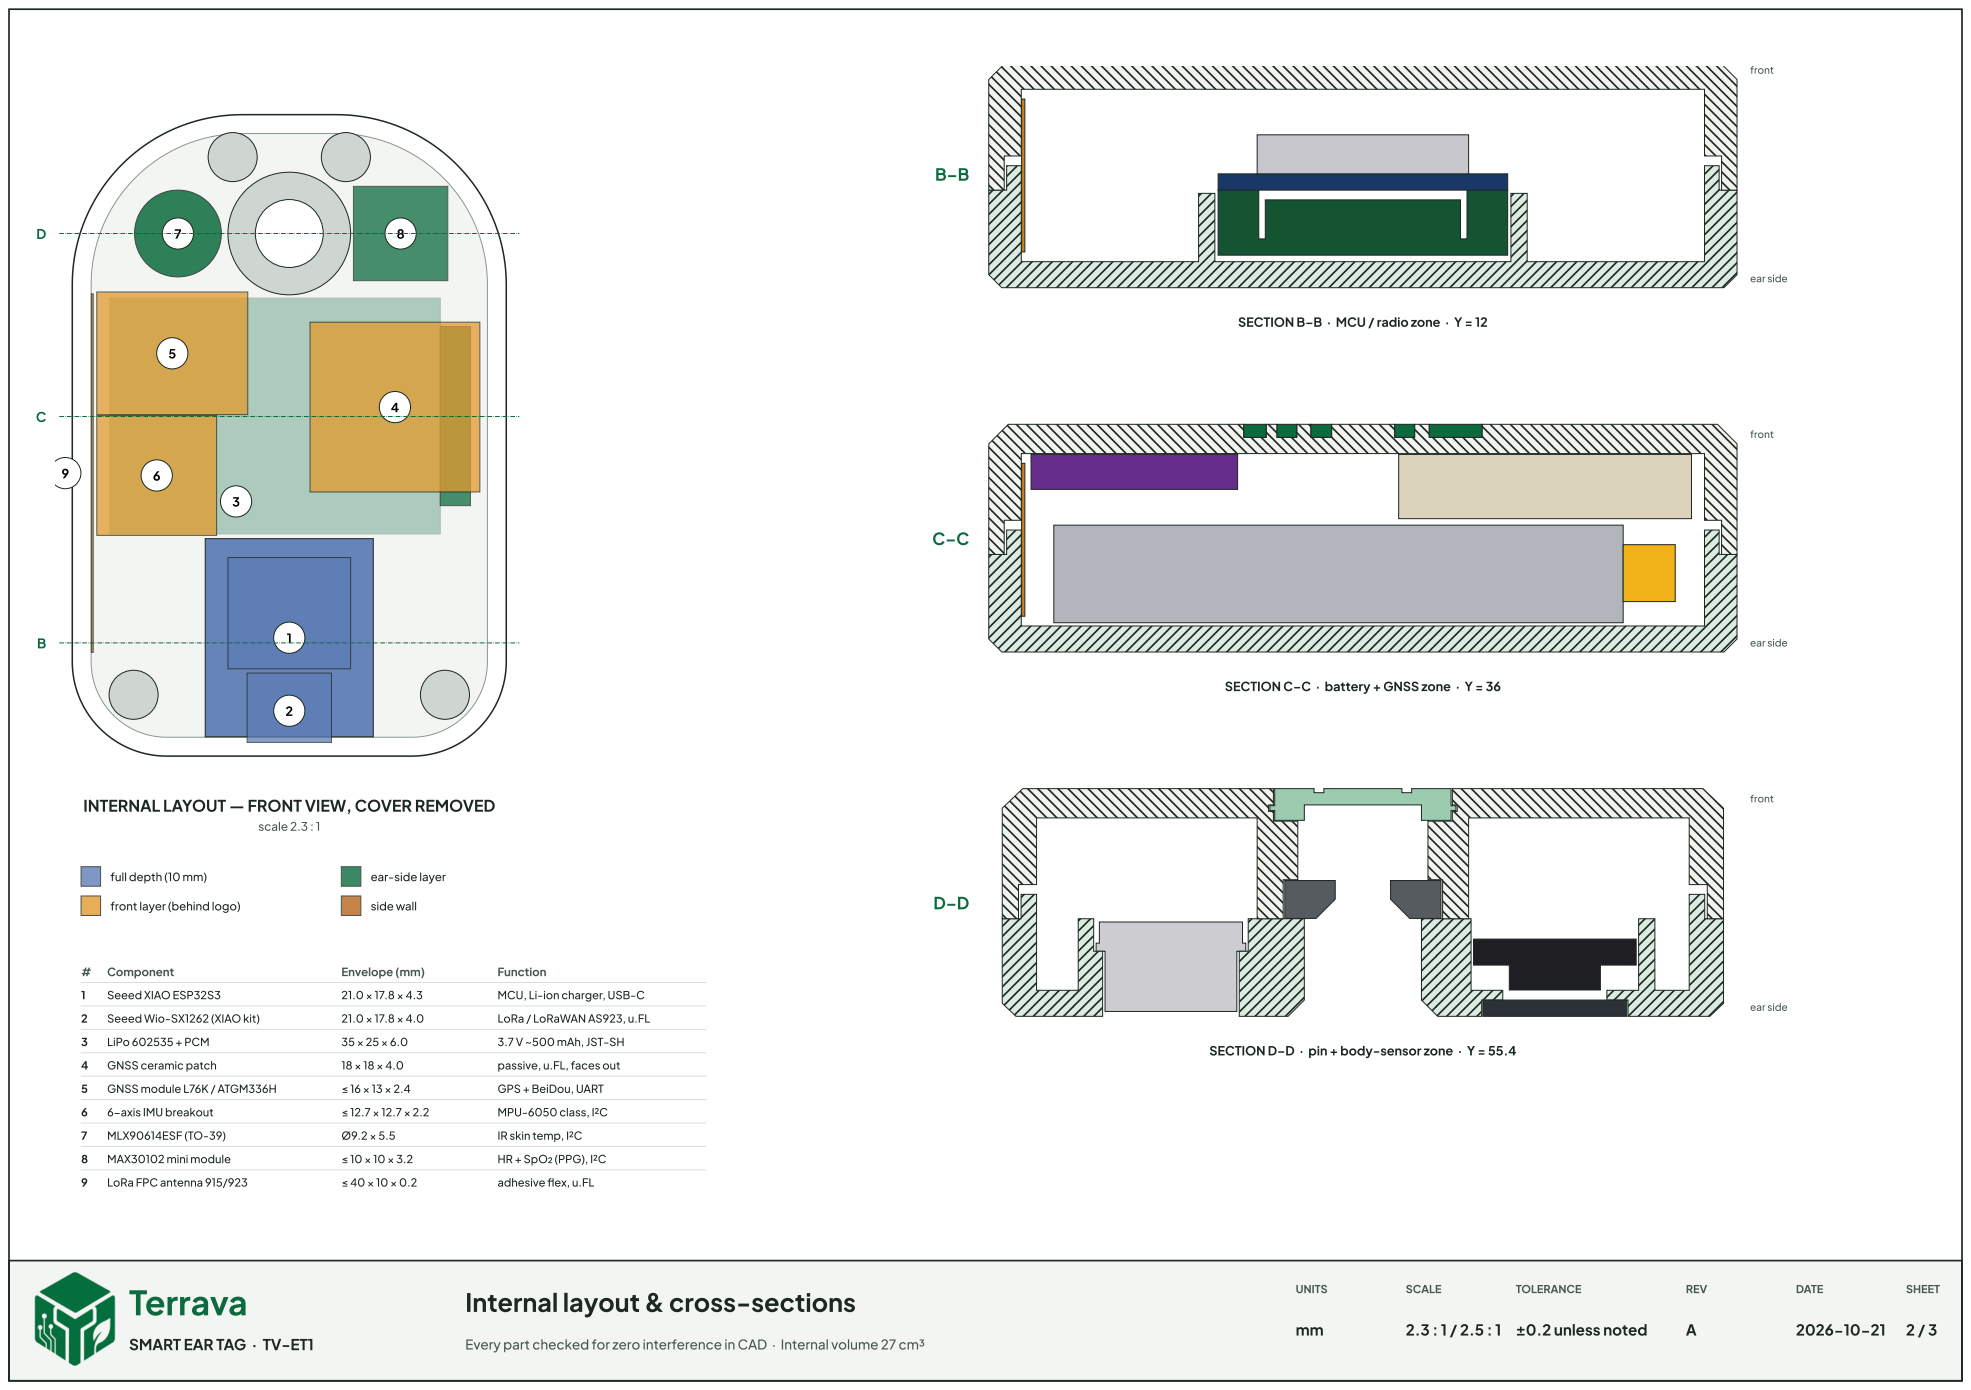
[picture p96: page 1]
scale 2.3 : 1; full depth (10 mm); ear-side layer; front layer (behind logo); side wall; Component; Envelope (mm); Function; Seeed XIAO ESP32S3; MCU, Li-ion charger, USB-C; Seeed Wio-SX1262 (XIAO kit); LoRa / LoRaWAN AS923, u.FL; LiPo 602535 + PCM; 3.7 V ~500 mAh, JST-SH; GNSS ceramic patch; passive, u.FL, faces out; GNSS module L76K / ATGM336H; GPS + BeiDou, UART; 6-axis IMU breakout; MPU-6050 class, I²C; MLX90614ESF (TO-39); IR skin temp, I²C; MAX30102 mini module; HR + SpO₂ (PPG), I²C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

SECTION B–B · MCU / radio zone · Y = 12

SECTION C–C · battery + GNSS zone · Y = 36

INTERNAL LAYOUT — FRONT VIEW, COVER REMOVED

SECTION D–D · pin + body-sensor zone · Y = 55.4

Internal layout & cross-sections

SMART EAR TAG · TV-ET1

Every part checked for zero interference in CAD · Internal volume 27 cm³
