StyNW7/Terrava/iot/firmware/gateway/include/secrets.example.h

#pragma once
// Copy to secrets.h (git-ignored) and fill in.

#define WIFI_SSID "farm-wifi"
#define WIFI_PASSWORD "change-me"

// Terrava backend base URL (no trailing slash) and the gateway API key issued on
// the Devices page ("Issue API key" on a gateway). The seeded demo gateway DEV-013
// uses the key below against a local backend.
#define TERRAVA_API_URL "http://192.168.1.10:4000/api/v1"
#define TERRAVA_GATEWAY_KEY "trv_gw_demo_green_valley_key_change_me_0001"
