StyNW7/Terrava/(commit log)

2026-07-20 feat: init push web prototype
2026-07-20 feat: update logout button
2026-10-24 Feat: relayouting web design
